Krishna-Gorai/riscv-cache-extension/paper/fig_filter.tex

%% =============================================================================
%%  fig_filter.tex -- the snoop filter's internal mechanism, standalone.
%%
%%  Build:  pdflatex fig_filter.tex   ->  fig_filter.pdf
%%
%%  Drawn in the terminology of the paper's Section V, so that every block and
%%  signal here is defined in the text:
%%    update port from each DCU: "tag + valid update" (the signals that write
%%        its Status-RAM and Tag-RAM), and "fill in flight + address"
%%    the INV REQ selected by the INV REQ arbiter: issued by PE i, address of w
%%        = set index . tag
%%    per (PE, way): Tag-RAM mirror (LUTRAM, read at the set index of w),
%%        valid bit (flip-flop), comparator "stored tag = tag of w", AND with
%%        the valid bit
%%    per PE: OR over the two ways -> "holds the line"; fill comparator ->
%%        "is fetching the line"; OR -> "holds or is fetching"
%%    exclude the requesting PE i -> sharer set S(w);  NOR -> S(w) = empty ->
%%        suppress the broadcast, else broadcast and grant by condition (1)
%%
%%  Routing rule, so that no two lines cross: the "address of w" is one bus
%%  that threads left to right through every block that reads it (Tag-RAM
%%  mirror, valid bit, fill comparator); those blocks take their DCU inputs
%%  from above, the tag comparator hangs below the bus on a tap (junction
%%  dot), and every result flows downwards. Gate inputs are reached by
%%  orthogonal jogs at different heights, the left source always feeding the
%%  left input, so the jogs never cross. Gates are the US shapes rotated so
%%  their inputs face up: after rotate=-90, "input 2" is the LEFT input and
%%  "input 1" the right one (input 4 leftmost on the 4-input NOR).
%%  PE 0 is drawn in full; PE 1-3 are identical and drawn collapsed.
%% =============================================================================
\documentclass[border=3pt]{standalone}
\usepackage{tikz}
\usepackage{times}
\usepackage{amssymb}
\usetikzlibrary{arrows.meta,calc,shapes.gates.logic.US}

\begin{document}
\begin{tikzpicture}[
  x=1mm, y=1mm, font=\scriptsize,
  box/.style  ={draw,rectangle,align=center,inner sep=1.2pt},
  ram/.style  ={box,fill=black!6},
  ff/.style   ={box,fill=black!16},
  op/.style   ={box,fill=white},
  pe/.style   ={box,fill=black!3},
  src/.style  ={box,fill=white},
  new/.style  ={box,fill=black!22,line width=1.1pt},
  g2/.style   ={draw,logic gate inputs=nn,logic gate input sep=5mm,rotate=-90,scale=0.5},
  g4/.style   ={draw,logic gate inputs=nnnn,logic gate input sep=4mm,rotate=-90,scale=0.5},
  ln/.style   ={draw,-{Latex[length=1.4mm]},line width=0.45pt},
  wire/.style ={draw,line width=0.45pt},
  bus/.style  ={draw,line width=1.1pt},
  mir/.style  ={draw,-{Latex[length=1.4mm]},dashed,dash pattern=on 1.6pt off 1.2pt,line width=0.7pt},
  dot/.style  ={circle,fill=black,inner sep=0,minimum size=1.2mm},
  lab/.style  ={font=\tiny,inner sep=0.7pt,fill=white,align=center},
  labr/.style ={font=\tiny,inner sep=0.4pt,rotate=90,anchor=center},
]

% ----------------------------------------------------------- the request
\node[src,minimum width=24mm,minimum height=13mm,anchor=east] (srcb) at (-18, 0)
  {INV REQ selected by\\the INV REQ arbiter:\\[1pt]
   issued by PE $i$,\\address of $w$};
\draw[bus] (-18, 0) -- (2, 0);
\node[lab,anchor=south] at (-8, 0.9) {address of $w$};
\node[lab,anchor=north] at (-8, -0.9) {(set index, tag)};
\draw[ln] (-36, -6.5) -- (-36, -60) -- (30, -60);
\node[lab,anchor=east] at (-36.8, -33) {$i$};

% ----------------------------------------------------------- PE 0 in full
\node[pe,minimum width=68mm,minimum height=7mm,anchor=south west] (dcu0) at (0, 12)
  {\textbf{DCU 0}\\[-1pt] {\tiny update port: its Status-RAM and Tag-RAM write signals; line fill in progress}};

% two ways, centres c = 12 and 38
\foreach \k/\c in {0/12, 1/38} {
  % on the bus: tap for "tag of w", then the Tag-RAM mirror, then the valid bit
  \node[dot] (tp\k) at (\c-10, 0) {};
  \node[ram,minimum width=12mm,minimum height=5mm] (tr\k) at (\c-3, 0)
    {Tag-RAM\\[-1pt]mirror};
  \node[ff,minimum width=6mm,minimum height=5mm] (vb\k) at (\c+7, 0) {valid};
  \draw[bus] (\c-11, 0) -- (\c-9, 0);
  \draw[bus] (\c+3, 0) -- (\c+4, 0);
  \draw[bus] (\c+10, 0) -- (\c+16, 0);
  % update port from DCU 0, straight down into both
  \draw[ln] (\c-3, 12) -- (\c-3, 2.5);
  \draw[ln] (\c+7, 12) -- (\c+7, 2.5);
  \node[labr] at (\c-4.3, 7.2) {tag};
  \node[labr] at (\c+8.3, 7.2) {valid};
  \node[lab] at (\c+2, 4.2) {way \k};
  % comparator below the bus: tag of w from the tap, stored tag from the mirror
  \node[op,minimum width=9mm,minimum height=5mm] (cp\k) at (\c-6.5, -11) {$=$};
  \draw[ln] (tp\k) -- (\c-10, -8.5);
  \draw[ln] (tr\k.south) -- (\c-3, -8.5);
  % AND with the valid bit; left input 2 from the comparator, right input 1
  % from the valid bit, each by its own jog
  \node[and gate US,g2] (an\k) at (\c-2, -22) {};
  \draw[ln] (cp\k.south) |- ($(an\k.input 2)+(0,2)$) -- (an\k.input 2);
  \draw[ln] (vb\k.south) |- ($(an\k.input 1)+(0,4)$) -- (an\k.input 1);
}
\node[lab,anchor=east] at (1.4, -5.2) {tag of $w$};
\node[lab,anchor=west] at (9.6, -5.2) {stored\\[-1pt]tag};
\node[lab,anchor=east] at (7.6, -19.6) {tag match};

% fill comparator, also on the bus, also fed from DCU 0
\node[new,minimum width=14mm,minimum height=7mm] (fc0) at (61, 0)
  {$=$\\[-1pt] {\tiny fill addr., line addr.\ of $w$}};
\draw[mir] (61, 12) -- (61, 3.5);
\node[lab,anchor=east] at (60.2, 7.5) {fill in flight\\[-1pt]+ address};
\draw[bus] (68, 0) -- (73, 0);

% OR over the two ways
\node[or gate US,g2] (orw) at (24, -36) {};
\draw[ln] (an0.output) |- ($(orw.input 2)+(0,2)$) -- (orw.input 2);
\draw[ln] (an1.output) |- ($(orw.input 1)+(0,4)$) -- (orw.input 1);
\node[lab,anchor=west] at (10.8, -28) {way 0 holds};
\node[lab,anchor=west] at (36.8, -28) {way 1 holds};
% OR with the fill term
\node[or gate US,g2] (orf) at (42, -50) {};
\draw[ln] (orw.output) |- ($(orf.input 2)+(0,2)$) -- (orf.input 2);
\draw[ln] (fc0.south) |- ($(orf.input 1)+(0,4)$) -- (orf.input 1);
\node[lab,anchor=west] at (24.8, -42) {PE 0 holds the line};
\node[lab,anchor=west] at (61.8, -25) {PE 0 is fetching the line};
\draw[ln] (orf.output) -- (42, -60);
\node[lab,anchor=west] at (42.8, -56.5) {PE 0 holds or is fetching the line};

% ----------------------------------------------------------- PE 1..3 collapsed
\foreach \j/\x in {1/84, 2/112, 3/140} {
  \node[pe,minimum width=22mm,minimum height=6mm,anchor=south] (dcu\j) at (\x, 12)
    {\textbf{DCU \j}};
  \node[pe,minimum width=22mm,minimum height=22mm] (blk\j) at (\x, -6)
    {\textbf{PE \j}\\[-1pt] same as PE 0:\\[-1pt] Tag-RAM mirror and\\[-1pt]
     valid bit per way,\\[-1pt] comparators, gates};
  \draw[ln]  (\x-4, 12) -- (\x-4, 5);
  \draw[mir] (\x+4, 12) -- (\x+4, 5);
  \draw[ln]  (blk\j.south) -- (\x, -60);
}
\draw[bus] (95, 0) -- (101, 0);
\draw[bus] (123, 0) -- (129, 0);
\node[lab,anchor=east] at (79.4, 8.5) {tag + valid};
\node[lab,anchor=west] at (88.6, 8.5) {fill};

% ----------------------------------------------------------- sharer set
\node[op,minimum width=122mm,minimum height=6mm,anchor=north west] (mask) at (30, -60)
  {exclude the requesting PE $i$ (a DCU is never told about its own write)};
\node[lab,anchor=east] at (29, -64.5) {sharer set $S(w)$,\\[-1pt] one bit per PE};

% NOR over the four bits: S(w) = empty. Input 4 is leftmost; the outer
% sources take the lower jogs so no jog spans a neighbour's vertical.
\node[nor gate US,g4] (nor) at (91, -76) {};
\draw[ln] (42, -66)  |- ($(nor.input 4)+(0,1.5)$) -- (nor.input 4);
\draw[ln] (84, -66)  |- ($(nor.input 3)+(0,4.5)$) -- (nor.input 3);
\draw[ln] (112, -66) |- ($(nor.input 2)+(0,4.5)$) -- (nor.input 2);
\draw[ln] (140, -66) |- ($(nor.input 1)+(0,1.5)$) -- (nor.input 1);

\node[op,minimum width=30mm,minimum height=9mm,anchor=west] (arb) at (138, -86)
  {INV REQ arbiter:\\[-1pt] grant condition (1)};
\draw[ln] (nor.output) |- (138, -86);
\node[lab,anchor=south west] at (93, -85.2) {1: $S(w)=\emptyset$, suppress the broadcast, grant at once};
\node[lab,anchor=north west] at (93, -86.8) {0: broadcast the INV REQ, grant when $\bigwedge_{j \ne i} r_j(t)$};

% ----------------------------------------------------------- legend
\node[ram,minimum width=5mm,minimum height=3mm,inner sep=0,anchor=west] at (-40, -96) {};
\node[font=\tiny,anchor=west] at (-34, -96) {distributed RAM (LUTRAM), read at the set index of $w$};
\node[ff,minimum width=5mm,minimum height=3mm,inner sep=0,anchor=west] at (30, -96) {};
\node[font=\tiny,anchor=west] at (36, -96) {flip-flops};
\node[new,minimum width=5mm,minimum height=3mm,inner sep=0,anchor=west] at (54, -96) {};
\node[font=\tiny,anchor=west] at (60, -96) {imminent residency (Section V-B)};
\draw[bus] (104, -96) -- (110, -96); \node[dot] at (107, -96) {};
\node[font=\tiny,anchor=west] at (112, -96) {bus with tap};
\draw[mir] (130, -96) -- (136, -96);
\node[font=\tiny,anchor=west] at (138, -96) {fill-in-flight signal};

\end{tikzpicture}
\end{document}
