Krishna-Gorai/riscv-cache-extension/paper/fig_exec.pdf

32x32 64x64 128x128
A, B Matrix Size

0

5000

10000

15000

Execution Time (103 Cycles)

Matrix Multiplication

Cores w/o Data Cache
Cores w/ Data Cache
+ Snoop Filter (this work)

32x32 64x64 128x128
Input Matrix Size

0

250

500

750

1000

1250
Execution Time (103 Cycles)

Convolution

256 | 512 | 1024
FFT Input Size per Sample

0

100

200

300

400

500

Execution Time (103 Cycles)

FFT

256 | 512 | 1024
FFT Input Size per Sample

0

100

200

300

400

500

Execution Time (103 Cycles)

FFT, cache-blocked
