Krishna-Gorai/riscv-cache-extension/paper/fig_capacity.pdf

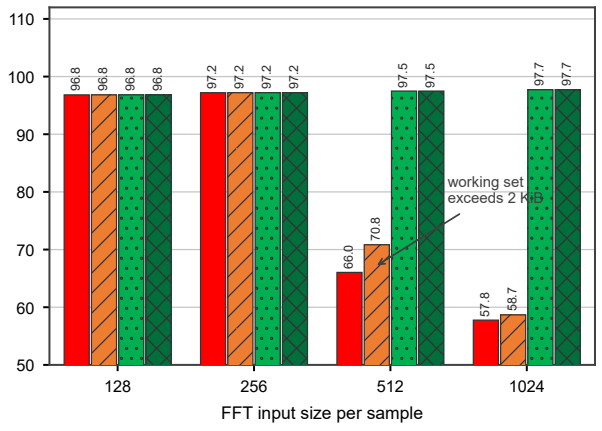
[picture p1: figure]
FFT input size per sample; working set exceeds 2 KiB

128 | 256 | 512 | 1024

### FFT input size per sample

0

100

200

300

400

500

600

## Execution time (103 cycles)

### Execution time

2-way 2 KiB (as stated)
4-way 2 KiB
2-way 8 KiB
2-way 16 KiB

### Read hit rate (%)

### Cache hit rate
