Krishna-Gorai/riscv-cache-extension/paper/date2027.tex

%% =============================================================================
%%  date2027.tex -- An Exact Snoop Filter for Seamless Cache Coherence
%%
%%  Build:  pdflatex date2027.tex   (twice)
%%  Camera ready, with names and the repository URL:
%%          pdflatex "\def\CAMERAREADY{}\input{date2027}"
%%
%%  Defaults to anonymous. DATE's blind-review policy for the research track
%%  must be confirmed before submission -- the repository URL de-anonymises the
%%  work instantly, so it is behind the same toggle as the author block.
%%
%%  Style rule for this file (2026-09-13): written in the register of the
%%  reference paper. Every abbreviation and every symbol is defined at first
%%  use, headings are descriptive, and each result is followed by its reason.
%%  Page budget: DATE allows 6 pages + 1 extra page for references ONLY. The
%%  draft is deliberately over that while the guide's review points are being
%%  worked through (2026-09-18: author said to ignore the limit for now). It
%%  MUST be brought back before submission; check with
%%    pdftotext -f 7 -l 7 date2027.pdf - | head -1     (must be REFERENCES)
%%  The cheapest single cut, measured, is Fig. 4 (memcpy latency): dropping it
%%  alone took the body back inside 6 pages with nothing else touched.
%% =============================================================================
\documentclass[conference]{IEEEtran}
\IEEEoverridecommandlockouts

\usepackage{cite}
\usepackage{amsmath,amssymb}
\usepackage{graphicx}
\usepackage{booktabs}
\usepackage{url}
\usepackage[hidelinks]{hyperref}

\ifdefined\CAMERAREADY \newif\ifanon \anonfalse \else \newif\ifanon \anontrue \fi

\begin{document}

\title{An Exact Snoop Filter for Seamless Cache Coherence in
FPGA-Based Multi-Core RISC-V}

\ifanon
  \author{\IEEEauthorblockN{Anonymous submission}}
\else
  \author{\IEEEauthorblockN{Krishna Gorai}
  \IEEEauthorblockA{Indian Institute of Technology Mandi\\
  Mandi, Himachal Pradesh, India}
  \and
  \IEEEauthorblockN{Bikram Paul}
  \IEEEauthorblockA{Indian Institute of Technology Mandi\\
  Mandi, Himachal Pradesh, India}}
\fi

\maketitle

\begin{abstract}
Private data caches allow the soft cores of an FPGA-based multi-core system to
hide the access latency of a shared memory, but the caches then have to be kept
coherent. A recently proposed cache extension for RISC-V multi-core systems
does this in hardware, with a snooping invalidation bus and without any
modification to the core. In this paper we look at the traffic on that bus.
We reproduce the cache extension at the register-transfer level, instrument
its snoopy bus, and count how many invalidation requests actually invalidate
a cache line in another core. On the benchmark kernels of the original
evaluation the answer is none. The kernels partition their data between the
processing elements, so every written line is private to the core that writes
it, and yet each write is still arbitrated across the whole system and
acknowledged by every other cache. A considerable fraction of each core's
cache busy time is spent waiting for the snoopy bus in this way, and for a
streaming kernel the overhead is larger than the benefit of the cache. We propose a snoop filter that keeps
a copy of the tag and valid bits of every data cache unit inside the snoopy
bus, so that the bus can suppress an invalidation request when no other cache
holds the addressed line or is fetching it. Conventional snoop filters sit at
the receiving cache and work from approximate or coarse-grained sharing
information. Ours is exact and sits at the source, where it becomes part of
the arbitration decision itself, because on this bus the dominant cost of an
unnecessary invalidation is the global serialization it causes and not the
remote tag lookups. A cost model of the bus protocol explains where the
saving comes from. The filter is evaluated in terms of execution time,
coherence correctness and FPGA resource utilization.
\end{abstract}

\begin{IEEEkeywords}
Cache Coherency, Snoop Filter, RISC-V, Multi-Core SoC, FPGA
\end{IEEEkeywords}

% =============================================================================
\section{Introduction}
% =============================================================================

Multi-core systems implemented on FPGAs are increasingly used for embedded and
edge computing, where several soft RISC-V cores share a common memory whose
access latency is high compared to the clock period of the cores. Private data
caches hide this latency. However, as soon as each core caches shared data
the copies have to be kept coherent, and the cost of coherence is charged
against the very performance the caches were added to provide, partly as
hardware for tag and status memories and partly as the time the cores spend
waiting for coherence actions that are serialized across the whole system.

Several hardware and software coherence schemes have been proposed for
scalable architectures~\cite{jetty,cgct,regionscout}, and the RISC-V ecosystem
provides coherent interconnect fabrics for large
systems~\cite{tilelink,openpiton,cifer}. Adopting one of these generally means
integrating with its coherence and interconnect infrastructure, and it may
require changes to the core or to its memory interface. For a designer working
with existing, already verified soft cores, that is the development cost worth
avoiding, and a seamless cache extension avoids it. Kamaleldin \emph{et
al.}~\cite{kamaleldin2024} attach a private, write-through Data Cache Unit
(DCU) to an unmodified RISC-V core through the core's ordinary data port and
keep the DCUs coherent with a snooping invalidation bus, entirely in
hardware.

In this work we reproduce the cache extension of~\cite{kamaleldin2024} at the
register-transfer level in order to find out how much of the coherence traffic
it generates is really necessary. We find that between 6\,\% and 33\,\% of
the time a core spends with an access in its cache goes to waiting for the
snoopy bus, and that over four benchmark kernels the system issues 1{,}048{,}821 invalidation
requests, not one of which invalidates a cache line in another DCU. The
kernels partition their arrays between the Processing Elements (PEs), so
almost every written line is private to one PE, but the bus has no way of
knowing this. We therefore propose an exact snoop filter that answers this
question before the bus arbitrates the request. Our contributions are listed
as follows:

\begin{itemize}
  \item We measure how much of the coherence traffic of the cache extension
        is necessary, and what the rest costs (Section~\ref{sec:measure}).
  \item We propose an exact source-side snoop filter that feeds cache
        residency and fill-in-flight information directly into the
        arbitration of the snoopy bus, so that an unnecessary invalidation
        request is suppressed before it is serialized across the system. A
        cost model of the bus protocol explains where its benefit comes from
        (Section~\ref{sec:filter}).
  \item We evaluate the filter in execution time, coherence correctness and
        FPGA resources, and measure directed invalidation as a possible next
        step (Sections~\ref{sec:eval} and~\ref{sec:rejected}).
\end{itemize}

The rest of the paper is structured as follows.
Section~\ref{sec:related} discusses related work, Section~\ref{sec:design}
describes the cache extension under study, and Section~\ref{sec:measure}
analyzes its coherence traffic. The snoop filter is presented in
Section~\ref{sec:filter} and evaluated in Section~\ref{sec:eval}.
Section~\ref{sec:rejected} reports on directed invalidation, and
Section~\ref{sec:concl} concludes the paper.

% =============================================================================
\section{Related Work}
\label{sec:related}
% =============================================================================

Snoop filtering itself is not new, and we do not claim it as our
contribution. JETTY~\cite{jetty} places a small filter in front of each
receiving cache and uses it to skip the snoops that would miss there anyway,
so that the energy of a tag lookup is not spent on them. Coarse-grain
coherence tracking~\cite{cgct} and RegionScout~\cite{regionscout} work at a
larger granularity: they track the sharing state of regions of hundreds or
thousands of bytes, and a region that is known to be unshared needs no
broadcast at all. All three were designed for SMP servers and large chip
multiprocessors, where the cost of a useless snoop is the energy and the
bandwidth of the remote tag lookups. In that setting an approximate answer is
good enough, because the error can be made one-sided: a filter that claims a
line may be held when it is not merely causes a lookup that would have
happened anyway.

The bus studied here charges for a useless invalidation in a different
currency. Only one invalidation is granted per clock cycle in the whole
system, and the grant is held back until every other cache is ready to accept
it, so the expense is the serialization imposed on every core rather than the
lookups performed by any one of them. Three consequences follow, and together
they are what distinguishes this work; Table~\ref{tab:related} summarizes
them. First, the filter has to sit at the source of the request and take part
in the arbitration decision, since a filter at the receiver cannot prevent a
request from being serialized. Second, it has to be exact rather than
conservative: it decides whether to arbitrate at all, so a false positive is
not a wasted lookup but a lost opportunity, and exactness also lets the same
structure answer \emph{which} caches hold the line, which we use in
Section~\ref{sec:rejected}. Being exact is affordable because the caches of
such a system are small. Third, a source-side filter must know about the line
fills that are in flight, a question that does not arise at the receiving
side, where the cache is aware of its own pending fill; Section~\ref{sec:fill}
shows that ignoring it loses invalidations.

\input{tab_related}

Coherent fabrics for RISC-V such as TileLink~\cite{tilelink},
OpenPiton~\cite{openpiton} and CIFER~\cite{cifer} solve the coherence problem
at a different scale, as complete memory systems. The design studied here is
an extension attached to an unmodified core through its existing memory port,
and that is what confines its coherence traffic to a single shared bus.

% =============================================================================
\section{The Cache Extension Under Study}
\label{sec:design}
% =============================================================================

\begin{figure*}[t]
\centering

\caption{Overview of the multi-core RISC-V architecture with the cache
extension of~\cite{kamaleldin2024} and the snoop filter added by this work
(shaded, with its mirror update port per DCU dashed). Every PE is wired as
PE~0; the signal names are those of Section~\ref{sec:design}.}
\label{fig:arch}
\end{figure*}

We describe the cache extension of~\cite{kamaleldin2024} as far as is needed
to follow the measurements, keeping to the terminology of the original paper.

\subsection{Multi-core RISC-V Architecture}

The target system, shown in Fig.~\ref{fig:arch}, consists of a scalable number
of RISC-V Processing Elements (PEs). Each PE hosts an in-order RV32 core, a
private Data Cache Unit (DCU), a scratchpad Instruction Tightly Coupled Memory
(ITCM), and an Instruction-Bridge and a Data-Bridge that connect the core to the
local memories and to a shared AXI4 crossbar, behind which sit a shared
instruction memory, used as boot memory, and a coherent shared data memory. A
single snoopy bus is connected to the DCU of every PE and manages the
invalidation of cache lines between the private DCUs.

\subsection{Data Cache Unit}

The DCU is a two-way set-associative, write-through, no-allocate data cache
with a Least Recently Used (LRU) replacement policy. Every write is forwarded
to the shared data memory, and a write that misses does not install a line.
Requests are processed in two sequential pipeline stages. The first stage
accepts a request either from the local core, which can be a read request
(READ REQ) or a write request (WRITE REQ), or from the snoopy bus, which can
only be an invalidation request (INV REQ). For a core request it reads the
valid bit from the Status-RAM and the tag from the Tag-RAM, and at the same
time forwards the request to the snoopy bus, a WRITE REQ as an INV REQ. In
the second stage the Hit Check Logic (HCL) decides between hit and miss and
the Cache Control Logic (CCL) acts on the request: a READ REQ that misses
issues a memory read request (MEM READ REQ) and fills the LRU way of the set
with the returned line, a WRITE REQ becomes a memory write request
(MEM WRITE REQ), and an INV REQ clears the valid bit of the addressed line if
it is resident. An INV REQ has priority over the local core; a core request
that occupies the first stage when one arrives is moved into a holding
register and presented again afterwards. A Stall Control Logic (SCL) stalls
the first stage until the bus grants its forwarded request, and the second
stage until the response (MEM RESP) of a MEM READ REQ or the grant of a
MEM WRITE REQ arrives, that is, for the access latency of the shared data
memory.

\subsection{Snoopy Bus}

The unit of coherence is the cache line, the same 16 bytes the DCU allocates
and refills. An INV REQ carries a line address, the receiving DCU compares it
against its tags at line granularity, and the screening described below works
at the same granularity, so two PEs writing different words of one line are
treated as sharing it.

The snoopy bus consists of two Round Robin (RR) arbiters, an Invalidation Table
and a Link Register. The first arbiter, which we call the INV REQ arbiter
from here on, arbitrates the INV REQs of all PEs and grants at most one per
clock cycle. When an INV REQ is granted, its address is broadcast to the DCUs
of all other PEs, which clear the addressed line if they hold it. The grant is
withheld until every other DCU is able to accept the broadcast, so that no
invalidation can be lost. This last rule is the one the rest of the paper
turns on. It couples the DCUs to each other: what a write costs is decided by
what every other DCU happens to be doing at that moment, and not by what any
cache actually holds, so the protocol charges the same price for a write that
nobody else cares about as for one that everybody has to hear. The second arbiter handles the atomic Load-Reserved
(LR) and Store-Conditional (SC) requests together with the Link Register. The
bus also guarantees a Multiple-Readers-Single-Writer (MRSW) invariant: plain
READ REQs are not arbitrated, but while a core has an INV REQ pending for a
line, recorded in the Invalidation Table, a READ REQ of another core to that
line is withheld until the INV REQ is granted.

\subsection{Reproduction and Experimental Setup}

We implemented this architecture in SystemVerilog in the configuration given
in the original paper: four PEs, each with an unmodified CV32E40P core and a
private 2\,KiB two-way DCU with 16-byte lines and 64 sets, a 256\,KiB shared
data memory and a 32\,KiB shared instruction memory behind an AXI4 crossbar.
A non-coherent version, in which each core accesses the shared data memory
directly through its Data-Bridge and has no DCU, is built from the same
sources by changing one parameter; it serves as the baseline for all
comparisons. The shared memories are modelled with a configurable access
latency, which we call the memory latency from here on. It is the number of
clock cycles between the acceptance of a MEM READ REQ and the first data beat
of its MEM RESP. We use three synthetic settings of it. Two cycles corresponds to the
on-chip block RAM (BRAM) of the original design, while eight and twenty cycles
are higher-latency configurations representative of off-chip access classes;
we did not implement an off-chip memory controller, and these figures are not
a model of one.

Execution time is read from the cycle counter of the cores as the number of
clock cycles until the slowest PE has finished. The benchmark kernels are the
memory copy, matrix multiplication, 2-D convolution and Fast Fourier
Transform (FFT) kernels of the original evaluation, which we refer to as
memcpy, matmul, conv2d and FFT. Each of them partitions its data between the
four PEs, and every run is checked against a golden result. In addition, each
DCU carries hardware counters for the cycles in which it holds a core request
(busy cycles), the cycles its first stage waits for a grant of the snoopy bus
(snoop-stall cycles), the INV REQs it receives, and those among them that
find a valid matching line to clear.

% =============================================================================
\section{Analysis of the Coherence Traffic}
\label{sec:measure}
% =============================================================================

\subsection{Time Spent Waiting for the Snoopy Bus}

We express the snoop-stall cycles of a DCU as a fraction of its busy cycles,
that is, of the time the core spends with an access in its cache. We call this
its cache busy time; it is not the total execution time, which also covers
everything the core does without touching the cache. At a memory latency of
two cycles the share is 14.3\,\% on memcpy,
15.8\,\% on matmul, 6.5\,\% on conv2d and 5.8\,\% on FFT. At a memory latency
of twenty it rises to 33.0\,\%, 32.9\,\%, 19.0\,\% and 12.2\,\%,
respectively. The share grows with the memory latency because each grant is
held for longer, as will be shown in Section~\ref{sec:model}. One might
suspect the READ REQs that the Invalidation Table withholds under the MRSW
invariant. We counted them, and across all four kernels not a single
READ REQ is withheld. For these workloads the measured waiting is therefore
attributable to the INV REQs.

\subsection{None of the Invalidation Requests Are Necessary}

We therefore let each DCU count the INV REQs it receives and how many of them
find a valid matching line to clear. We call an INV REQ useful if at least
one other DCU clears a line because of it. The system issues 823{,}338
INV REQ broadcasts on matmul, 139{,}182 on conv2d, 61{,}683 on FFT and
24{,}618 on memcpy, more than a million in total, and on all four kernels the
number of useful ones is zero. To make sure the counter itself works, we ran
it on our coherence testbench of Section~\ref{sec:eval}, which shares data on
purpose; there it reports 345 useful INV REQs out of 921.

The zeros are thus a property of the kernels as much as of the design, and we
want to be plain about it. These four kernels are data-parallel and partition
their arrays between the PEs, so practically every written line belongs to one
PE only, and a reader is entitled to ask whether the result survives once the
data really is shared. It does, and for a reason that the zeros make easy to
miss: what the filter removes is not sharing but the announcement of writes to
caches that do not hold the line, and a workload can share a great deal and
still make almost all of those announcements pointless. We therefore added a
fifth kernel in which the PEs exchange data every step, and report it
separately in Section~\ref{sec:shared}. It is also the kernel we use in
Section~\ref{sec:rejected} to measure directed invalidation.

% =============================================================================
\section{Proposed Snoop Filter}
\label{sec:filter}
% =============================================================================

\subsection{Structure}

Before it grants an INV REQ, the bus needs to know whether there is any other
DCU that has to receive it. The proposed snoop filter answers this with a
mirror of the tag and valid bits of all DCUs, kept inside the snoopy bus. Only
two events change the state of a DCU: a line fill, which writes a tag into a
way and sets its valid bit, and an invalidation, which clears a valid bit.
Each DCU exports these two events on a small update port driven by the same
signals that write its own Status-RAM and Tag-RAM, which keeps the mirror
synchronized with the cache state. Section~\ref{sec:sva} checks that
synchronization as an assertion rather than leaving it as a claim. For the
INV REQ selected by the arbiter, the
set index of its address reads one entry from every array, the stored tag is
compared with the tag of the address and the result is ANDed with the valid
bit; the two ways of each DCU are ORed, and the requesting PE is excluded.
This path is shown in Fig.~\ref{fig:filter}. A hashed structure such as a
Bloom filter would be smaller, but it can only over-approximate the set of
resident lines, and removing an entry from one needs exactly the information
the mirror already holds.

\begin{figure}[t]
\centering

\caption{Decision path of the snoop filter for the INV REQ selected by the
arbiter, issued by PE $i$ with address of $w$. The address bus reads every
Tag-RAM mirror and valid bit at its set index. PE~1--3 are identical to PE~0.
The fill comparator is shaded; it is the term of Section~\ref{sec:fill}.}
\label{fig:filter}
\end{figure}

\subsection{Cache Lines in Flight}
\label{sec:fill}

A mirror of the tag arrays answers the question \emph{does another cache hold
this line?} The question the bus actually has to ask is \emph{does another
cache hold this line, or is it about to hold it because it is fetching it?}
The difference between the two is small enough to overlook and large enough to
break coherence. Consider a DCU that has issued a
MEM READ REQ for a missing line and is waiting for the MEM RESP. It holds
nothing for that line yet, so the line does not appear in the mirror, and yet
this DCU is precisely the one that must receive an INV REQ for it, because
receiving it during this interval is what cancels the fill. Suppress the
broadcast and the DCU installs a line that has already been invalidated. What
the bus needs is therefore residency \emph{or imminent residency}. Each DCU exports, in addition to its
mirror updates, a signal indicating that a line fill is in progress together
with its address, and the filter answers over the union of the mirror and
these fill-in-flight signals. The fill signal stays asserted from the cycle
the MEM READ REQ is issued until the cycle the line is written into the cache,
which is also the cycle in which the mirror learns the new tag, so the line is
covered at every moment by one of the two. This is not just a precaution. Over
ten randomized interleavings of our coherence testbench, 20 out of 2{,}241
granted INV REQs addressed a line that no other DCU held but one DCU was
fetching, and a mirror of resident lines alone would have suppressed each of
them wrongly.

\subsection{Correctness of Suppression}

When the filter reports that no other DCU holds the addressed line or is
fetching it, a broadcast of the INV REQ could not clear a line anywhere, so
leaving it out cannot be observed. Everything
else in the bus stays as it was: INV REQs that are needed are still
arbitrated, broadcast and acknowledged as before, and the Invalidation Table
still withholds READ REQs according to the MRSW invariant.

\subsection{Checking the Properties}
\label{sec:sva}

The argument above rests on two claims: that the mirror agrees with the caches,
and that a suppressed invalidation was one that no other DCU needed. A counter
that fires 20 times in 2{,}241 grants shows that a case was reached; it says
nothing about the cycles in which it was not. We therefore state both claims as
properties and check them, by proof where that is possible and by assertion in
simulation otherwise.

\subsubsection{Proof}
The filter's own obligation is that it must never report that nobody holds a
line when somebody does. That direction is the one that matters: a false
negative makes the bus suppress an invalidation that was needed, whereas a
false positive costs only a broadcast, which is what the unfiltered design
sends on every write in any case. We prove it against a reference model of a
single cache entry, with the entry -- which core, which set, which way -- left
free for the solver to pick, so that a proof covers every entry of every cache
rather than one chosen by hand. Nothing constrains the update port, so the
proof holds for every sequence of fills and invalidations the caches could
produce, not only those a testbench happens to generate. Property-directed
reachability discharges it in 331\,s with Yosys and ABC, unbounded, for four
cores, two ways, 32 sets and 26-bit addresses. To confirm the property is not
vacuous, we reran the same proof against a filter modified to ignore its
second way, and it fails in six seconds with a counterexample three cycles
long.

\subsubsection{Assertions in simulation}
The other two claims involve the DCUs and the bus, which are far larger, so we
check them in simulation rather than proving them. They are stated against the
DCUs' own Status-RAM, Tag-RAM and fill state, never against the filter's
outputs, which would be circular:
\begin{itemize}
  \item[P1] every entry of the mirror equals the corresponding entry of that
        DCU's arrays, in the valid bit and, where valid, in the tag;
  \item[P2] when the bus grants an INV REQ without broadcasting it, no other
        DCU holds the addressed line;
  \item[P3] the same, for a DCU that holds nothing yet but is fetching it.
\end{itemize}
P1 is the meaning of the word exact, and P3 is the property a mirror of
committed tags alone violates. Over ten randomized interleavings the
properties held in every cycle: 81{,}734 cycles in total, 923 suppressions
checked against the real cache state, and 78{,}336 mirror entries compared,
each entry of the mirror being visited 153 times.

\subsection{Cost Model}
\label{sec:model}

In this section we work out from the bus protocol what suppressing a
broadcast is worth, and then check the result against the measurements. Let
$P$ be the number of PEs, indexed by $i$ and $j$. For a WRITE REQ $w$ issued
by PE $i$, let $a(w)$ be the clock cycle in which $w$ enters the first stage
of its DCU and $g(w)$ the cycle in which the corresponding INV REQ is granted.
Let $\mathrm{arb}(t)$ be the PE selected by the INV REQ arbiter in cycle $t$,
and let $r_j(t) = 1$ if the DCU of PE $j$ can accept an INV REQ in cycle $t$.
The sharer set $S(w)$ is the set of PEs other than $i$ whose DCU holds or is
fetching the line addressed by $w$. The original protocol grants an INV REQ
in the first cycle in which the arbiter selects it \emph{and} every other DCU
is ready to accept it:
\begin{equation}
g(w) = \min\Big\{t \ge a(w) : \mathrm{arb}(t) = i \;\wedge\; \textstyle\bigwedge_{j \ne i} r_j(t)\Big\}.
\label{eq:grant}
\end{equation}
A DCU is ready only while its first stage does not already hold an INV REQ,
and an INV REQ leaves that stage only when the second one is free, which it is
not for the full memory latency of any MEM READ REQ or MEM WRITE REQ in
progress. On grant, an INV REQ is inserted into the first stage of each of the
other $P{-}1$ DCUs, where it takes priority over the local core, so each of
those pipelines loses a cycle if it had a core request to process. The cost of
$w$ to the whole system is therefore
\begin{equation}
C(w) = \big(g(w) - a(w)\big) + \sum_{j \ne i} \rho_j\big(g(w)\big),
\label{eq:cost}
\end{equation}
where $\rho_j(t) \in \{0, 1\}$ is one if the DCU of PE $j$ had a core request
to delay in cycle $t$. The
conjunction in (\ref{eq:grant}) ties the pipelines of all PEs together: a
WRITE REQ on PE $i$ has to wait until a MEM READ REQ on PE $j$ has completed,
whether or not the two PEs share any data at all. This is the reason why the
snoop-stall share of Section~\ref{sec:measure} grows with the memory latency.
And neither term of (\ref{eq:cost}) depends on which lines the caches hold.

With the filter, the cost does depend on the cache state. When $S(w)$ is read
from the mirror, the grant condition becomes $\mathrm{arb}(t) = i \wedge
\big(S(w) = \emptyset \vee \bigwedge\nolimits_{j \ne i} r_j(t)\big)$, and
INV REQs are inserted into the other DCUs only when $S(w) \ne \emptyset$. For
a WRITE REQ with an empty sharer set, both terms of (\ref{eq:cost}) vanish
and only the arbitration wait is left, which is non-zero only when two PEs
present a WRITE REQ in the same cycle. If every WRITE REQ of a kernel has an
empty sharer set, which is what Section~\ref{sec:measure} found for all four
kernels, the saving over the whole kernel is the entire coherence overhead
less the arbitration collisions. That is the same saving an oracle would
obtain by suppressing every broadcast.

Both terms of (\ref{eq:cost}) can be observed, so the model can be checked
rather than fitted. The snoop-stall cycles removed by the filter are the first
term and give a lower bound on the saving; the same plus one cycle per
broadcast received gives an upper bound. Per DCU, at a memory latency of two,
the measured saving falls inside this bracket on every kernel: matmul
$120{,}539 \le 243{,}100 \le 326{,}373$ cycles, conv2d $5{,}185 \le 13{,}795
\le 39{,}980$, FFT $892 \le 4{,}865 \le 16{,}312$, memcpy $1{,}792 \le 2{,}302
\le 7{,}946$.

In hardware, the mirror is one memory array per (PE, way) pair, addressed by
the set index. The tags are kept outside any reset, because a tag is only
compared when its valid bit is set, and this lets them map to distributed RAM
(LUTRAM); the valid bits are kept in flip-flops, where they can be reset and
read for all arrays at once. Our first implementation held both under an
asynchronous reset, and Vivado mapped it entirely to flip-flops: 11{,}776 of
them and 3{,}202 LUTs, against 512 and 408 here.

% =============================================================================
\section{Evaluation and Performance Analysis}
\label{sec:eval}
% =============================================================================

\subsection{Execution Time}

\begin{figure*}[t]
\centering

\caption{Execution time of the benchmark kernels over the non-coherent
system, the coherent system with the cache extension, and the coherent system
with the proposed snoop filter. The fourth panel is the FFT with its stages
reordered so that its working set fits into the cache.}
\label{fig:exec}
\end{figure*}

\input{tab_exec}

Fig.~\ref{fig:exec} shows the execution time of the matmul, conv2d and FFT
kernels for the problem sizes used in the original evaluation, and
Table~\ref{tab:exec} lists the cycle counts behind it. For matmul and conv2d
the cache extension reduces the execution time by roughly 40\,\% at every
problem size, as in the original evaluation. The reduction does not
fall off with the problem size because what has to stay resident is not the
whole data set but only the reuse footprint of the kernel, the bytes a core comes
back to before moving on. For matmul this is one row of the
second matrix, $4N$ bytes for an $N \times N$ matrix of 32-bit words; for
conv2d it is the three-row sliding window of the input, $12N$ bytes. At the
largest problem size these come to 512\,B and 1536\,B, and both fit into the
2\,KiB DCU.

For FFT this no longer holds. The original evaluation reports a uniform
reduction of about 23\,\%. We match it at $N{=}256$ points, but the reduction
disappears at $N{=}512$ and becomes negative at $N{=}1024$, where the cache
makes the kernel slower than having no cache. The reuse footprint explains
this too. The FFT touches all $N$ complex points in every stage, $8N$
bytes in total, which is 2\,KiB at $N{=}256$ and 8\,KiB at $N{=}1024$. At
$N{=}512$, doubling the associativity at 2\,KiB recovers only 3.8\,\% of the
execution time, whereas quadrupling the capacity recovers 24.5\,\%, so the
cause is capacity. With an 8\,KiB DCU, FFT reproduces the original result at
every size (24.8, 24.8 and 24.5\,\%). With the 2\,KiB stated in the original
text it does not, so the reported result implies either a larger cache or a
smaller working set than described.

The collapse comes from the order in which the kernel accesses its data, and
the fourth panel of Fig.~\ref{fig:exec} shows that it can be removed in
software. A radix-2 butterfly in stage $s$ pairs elements $2^s$ positions
apart; once $2^s$ is a multiple of a block size $B$, the remaining stages fall
apart into $B$ independent transforms over strided columns. Running the early
stages block by block and the late ones column by column keeps the working set
inside the DCU, and every butterfly still sees the same operands, so the
output is bit-identical. At $N{=}1024$ the reduction improves from
$-4.3\,\%$ to $+10.4\,\%$, and to $18.2\,\%$ with the filter; at $N{=}256$ the
extra loop structure costs about 6\,\%. The filter removes coherence traffic,
not cache misses, so its contribution stays at seven to eight percentage
points in both FFT panels.

Compared with the coherent system without the filter, the filter improves the
execution time by $1.222\times$ on matmul, $1.123\times$ on memcpy,
$1.089\times$ on conv2d and $1.061\times$ on FFT, a geometric mean of
$1.122\times$. We also compare against an oracle, that is, a bus that
suppresses every INV REQ broadcast unconditionally. Simulating such a bus is
only sound because none of the broadcasts are needed on these kernels. The
filter reaches the oracle on every kernel, cycle for cycle, as the cost model
of Section~\ref{sec:model} predicts. The snoop-stall counter confirms the
mechanism. On conv2d it falls from 20{,}848 cycles to 109, and on memcpy from
7{,}168 to 1. On FFT it falls only from 6{,}521 to 2{,}955, because the LR and
SC requests used for synchronization still have to pass through the arbiters.

\subsection{Memory Copy Latency}

\begin{figure*}[t]
\centering

\caption{Memory copy latency for several data transfer sizes at memory
latencies of two, eight and twenty cycles. At two the cache extension is
slower than the non-coherent system at every size; the ${\approx}50\,\%$
reduction of the original evaluation appears between eight and twenty.}
\label{fig:memcpy}
\end{figure*}

The memcpy kernel gave the most unexpected result. At a memory latency of
two cycles the coherent system with the cache extension is actually
\emph{slower} than the non-coherent system without any cache, at $0.975\times$
the speed of the baseline; with the filter it is $1.095\times$ faster. The
slowdown is the cost of announcing private writes, and Fig.~\ref{fig:memcpy}
shows that it holds at every transfer size: from 4 to 32\,KiB the cache
extension is 2.5\,\% to 7.6\,\% slower than the baseline, and the filter turns
that into a gain of 8.2\,\% to 9.0\,\%. Raising the memory
latency brings back the result of the original evaluation, with a latency
reduction of 34\,\% at a memory latency of eight and 56\,\% at twenty,
against the roughly 50\,\% reported there. A streaming kernel reuses no data,
so when there is little memory latency to hide, only the coherence overhead
is left.

\subsection{A Workload That Does Share Data}
\label{sec:shared}

\input{tab_stencil}

The four kernels above never make the filter let a broadcast through, so on
their own they cannot answer what happens when the data is genuinely shared.
For that we use a fifth kernel, a five-point Jacobi stencil on a
$32\times32$ grid over eight time steps. Each PE owns a band of rows and
exchanges its two boundary rows with its neighbours at every step, so the
sharing is real, it is periodic, and the sharer set of a boundary write is
exactly one of the other three PEs.

Table~\ref{tab:stencil} gives the result. The unfiltered system delivers
27{,}690 invalidations over the run, of which 168 are useful: sharing this
regular still leaves 99.4\,\% of the announcements pointless, which is the
point the four private-data kernels state in their extreme form. The filter
delivers 504 of them and keeps all 168 useful ones, a 55-fold reduction in
traffic, and it is worth $1.015\times$ at a memory latency of two,
$1.049\times$ at eight and $1.113\times$ at twenty. The gain is smaller than
on the private-data kernels, as the cost model requires: writes to a boundary
row have a non-empty sharer set, so both terms of (\ref{eq:cost}) survive for
them and only the interior of each band is suppressed. What the stencil shows
is that the benefit degrades gracefully with the amount of real sharing
rather than disappearing at the first shared line.

\subsection{Coherence Verification}

The four data-parallel kernels never make the filter let a broadcast through,
so on their own they cannot show that it is safe. Our coherence
testbench does. It runs a producer/consumer exchange and a randomized
four-core stress test over a small shared window, so that half of its
INV REQs are useful, and with the filter it passes 3{,}112 checks.
Among them is a version-monotonicity check: a core that has observed version
$k$ of a location must never afterwards observe an older version, which is
the symptom of a lost invalidation. The filter suppressed 282 of 921
broadcasts and delivered every one that was needed.

\subsection{Resource Utilization and Timing}

\input{tab_hier}

Table~\ref{tab:fpga} gives the post-place-and-route resource utilization with
the filter, obtained with Vivado 2025.1 for an AMD/Xilinx Zynq UltraScale+
XCZU7EV at 60\,MHz, which is the clock frequency of the original design. The
filter costs 1{,}064 look-up tables (LUTs) and 516 flip-flops on top of the
coherent system without it, under 4\,\% of that system, and no BRAM or DSP
blocks. Both systems meet all timing constraints, at $+1.199$\,ns of worst
negative slack with the filter and $+1.265$\,ns without, so the filter costs
66\,ps on a 16.667\,ns clock period. Both numbers come from the same Vivado
session, because separate runs of this design vary by up to 1.7\,ns in slack.
At 75\,MHz an earlier pair of builds had only the unfiltered system meeting
timing, on a path that is 86\,\% routing delay, so we evaluate at 60\,MHz.

% =============================================================================
\section{Directed Invalidation}
\label{sec:rejected}
% =============================================================================

Since the mirror knows not only \emph{whether} another DCU holds the line but
also \emph{which} ones do, the bus could deliver the INV REQ only to the
members of $S(w)$ and wait only for those. Only an exact filter may do this:
under multicast a missing sharer bit drops an invalidation that was needed,
whereas under suppression it would only have cost a redundant broadcast.

We measured it on the stencil kernel of Section~\ref{sec:shared}, whose
sharer sets make it the best case for steering. The mechanism does what it
was built to do: it delivers 168 invalidations, every one of them useful,
against the filter's 504, and it reduces the residual snoop stall by up to a
factor of eleven. The execution time improves by 0.1\,\% to 0.3\,\%. The
reason is visible in (\ref{eq:cost}): once suppression has removed every
WRITE REQ with an empty sharer set, what is left belongs to writes that some
other DCU genuinely has to be told about, and for those the writer has to
wait whether the broadcast is steered or not. Removing all of the filtered
design's remaining snoop stall would be worth at most 3.4\,\% at a memory
latency of twenty, and directed invalidation collects a small fraction of
that. We report it because the question "why not just multicast?" is the
obvious one to ask of an exact filter, and the answer turns out to be that
exactness is worth having for suppression, not for steering.

% =============================================================================
\section{Conclusion}
\label{sec:concl}
% =============================================================================

On the benchmark kernels of its own evaluation, the seamless cache extension
we reproduced spends 6\,\% to 33\,\% of each core's cache busy time on
invalidation requests that invalidate nothing. An exact mirror of the tag and
valid bits of all DCUs, covering the lines being fetched as well, lets the bus
suppress this traffic for 1{,}064 LUTs and is worth $1.122\times$.

\ifanon
\else
The design, the measurements and the scripts that regenerate every table are
available at \url{https://github.com/Krishna-Gorai/riscv-cache-extension}.
\fi

%% DATE allows "one extra page ... only for bibliographic references". The
%% body must end by page 6; page 7 is references only.
\newpage
\begin{thebibliography}{1}
\bibitem{kamaleldin2024}
A.~Kamaleldin, M.~Nickel, S.~Wu and D.~G\"ohringer,
``Seamless Cache Extension for FPGA-based Multi-Core RISC-V SoC,''
in \emph{Proc. IEEE 37th Int. System-on-Chip Conf. (SOCC)}, 2024.

\bibitem{jetty}
A.~Moshovos, G.~Memik, B.~Falsafi and A.~Choudhary,
``JETTY: Filtering Snoops for Reduced Energy Consumption in SMP Servers,''
in \emph{Proc. 7th Int. Symp. High-Performance Computer Architecture (HPCA)},
2001.

\bibitem{cgct}
J.~F.~Cantin, M.~H.~Lipasti and J.~E.~Smith,
``Improving Multiprocessor Performance with Coarse-Grain Coherence Tracking,''
in \emph{Proc. 32nd Int. Symp. Computer Architecture (ISCA)}, 2005, pp.
246--257.

\bibitem{regionscout}
A.~Moshovos,
``RegionScout: Exploiting Coarse Grain Sharing in Snoop-Based Coherence,''
in \emph{Proc. 32nd Int. Symp. Computer Architecture (ISCA)}, 2005, pp.
234--245.

\bibitem{tilelink}
W.~Terpstra,
``TileLink: A Free and Open-Source, High-Performance Scalable Cache-Coherent
Fabric Designed for RISC-V,'' in \emph{RISC-V Workshop}, 2017.

\bibitem{openpiton}
J.~Balkind \emph{et al.},
``OpenPiton+Ariane: The First Open-Source, SMP Linux-booting RISC-V System
Scaling from One to Many Cores,'' in \emph{Workshop on Computer Architecture
Research with RISC-V (CARRV)}, 2019.

\bibitem{cifer}
A.~Li \emph{et al.},
``CIFER: A Cache-Coherent 12nm 16mm$^2$ SoC with Four 64-Bit RISC-V Application
Cores, 18 32-Bit RISC-V Compute Cores, and a 1541 LUT6/mm$^2$ Synthesizable
eFPGA,'' in \emph{IEEE Int. Solid-State Circuits Conf. (ISSCC)}, 2023.
\end{thebibliography}

\end{document}
