Krishna-Gorai/riscv-cache-extension/paper/tab_hier.tex

%% Per-module resource breakdown. Generated from
%%   python scripts/table1.py filtered
%% and transcribed here; regenerate that if the build changes.
%%
%% Single column, in the shape of the original's Table I: the module tree down
%% the left, then LUTs, FFs, BRAMs, DSPs, and Available / Utilisation rows
%% under the rule. The instance count is folded into the name and the LUTRAM
%% column is gone -- the one number from it that matters, the filter's 208
%% LUTRAM out of 408, is stated in the text where it is argued.
%%
%% Re-measured 2026-09-08 against the RTL that covers fills in flight, both
%% variants in one batch. No total row inside the tree on purpose: Vivado's
%% figure for the SoC is not the sum of the rows above it -- a LUT shared across
%% a hierarchy boundary counts against both children but once against the
%% parent -- so a total under the column would read as an arithmetic error. The
%% tool's own figures sit below the rule instead, where they are plainly a
%% separate statement.
\begin{table}[t]
\caption{Post-place-and-route resource utilization of the coherent multi-core
system with the proposed snoop filter, AMD/Xilinx XCZU7EV at 60\,MHz.}
\label{tab:fpga}
\centering
\scriptsize
\setlength{\tabcolsep}{3.5pt}
\begin{tabular}{@{}lrrrr@{}}
\toprule
Module & LUTs & FFs & BRAMs & DSPs \\
\midrule
\textbf{Processing element} ($\times$4)      & 17{,}833 & 9{,}948 & 32 & 20 \\
\quad RISC-V core, CV32E40P                  & 16{,}929 & 8{,}404 &  0 & 20 \\
\quad ITCM + Instr.-Bridge                   &      252 &      36 & 32 &  0 \\
\quad Data-Bridge                            &      319 &      32 &  0 &  0 \\
\quad AXI4 masters ($\times$3 per PE)        &      333 & 1{,}476 &  0 &  0 \\
\textbf{Cache extension}                     & \textbf{6{,}540} & \textbf{4{,}628} & 20 & 0 \\
\quad Data Cache Unit ($\times$4)            & 5{,}816 & 3{,}998 & 20 &  0 \\
\quad Snoopy bus                             &      728 &     630 &  0 &  0 \\
\quad\quad \textbf{snoop filter (this work)} & \textbf{408} & \textbf{512} & 0 & 0 \\
\textbf{AXI4 crossbar}                       & 2{,}125 &     279 &  0 &  0 \\
\textbf{Shared data memory}, 256\,KiB        &      724 &     150 & 64 &  0 \\
\textbf{Shared instr.\ memory}, 32\,KiB      &      506 &      86 &  8 &  0 \\
\midrule
Whole device, as reported by the tool        & 27{,}845 & 15{,}670 & 124 & 20 \\
Available                                    & 230{,}400 & 460{,}800 & 312 & 1{,}728 \\
Utilisation (\%)                             &    12.09 &     3.40 & 39.74 & 1.16 \\
\bottomrule
\end{tabular}
\end{table}
