Krishna-Gorai/riscv-cache-extension/paper/fig_memcpy.pdf

4 KiB | 8 KiB | 16 KiB | 32 KiB
Data Transfer Size

0

10

20

30

40

Latency (10

3 Cycles)

MemLat 2 (on-chip BRAM)

4-Cores w/o Data Cache
4-Cores w/ Data Cache + Snoop Filter (this work)
4 KiB | 8 KiB | 16 KiB | 32 KiB
Data Transfer Size

0

20

40

60

80

Latency (10

3 Cycles)

MemLat 8

4 KiB | 8 KiB | 16 KiB | 32 KiB
Data Transfer Size

0

50

100

150

Latency (10

3 Cycles)

MemLat 20 (off-chip class)
