Krishna-Gorai/riscv-cache-extension/paper/fig_filter.pdf

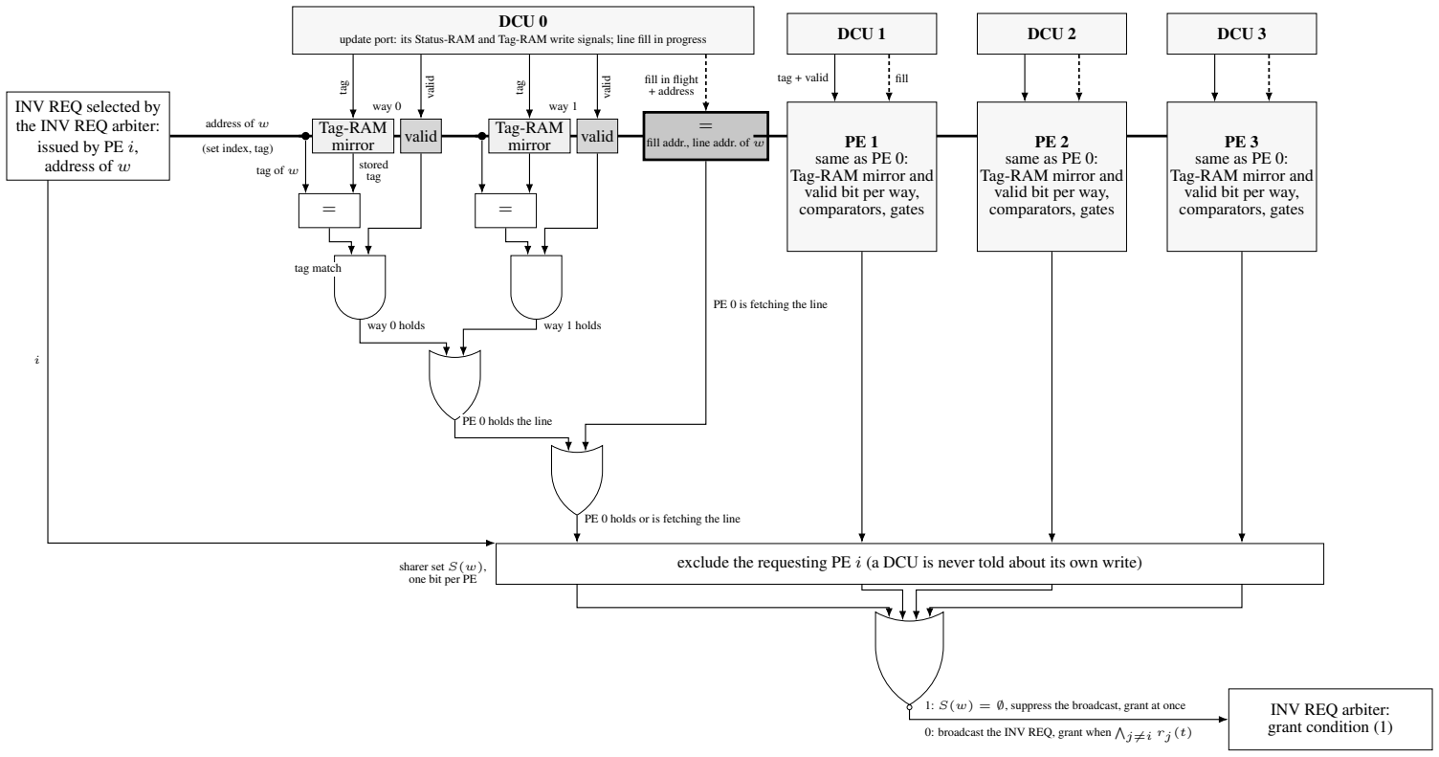
[picture p2: figure]
INV REQ selected by the INV REQ arbiter: issued by PE i, address of w; address of w; (set index, tag); DCU 0; Tag-RAM; mirror; valid tag; valid; way 0; way 1; tag of w; stored; tag; tag match; fill addr., line addr. of w; fill in flight + address; way 0 holds; way 1 holds; PE 0 holds the line; PE 0 is fetching the line; PE 0 holds or is fetching the line; DCU 1; PE 1 same as PE 0: Tag-RAM mirror and valid bit per way, comparators, gates; DCU 2; PE 2 same as PE 0: Tag-RAM mirror and valid bit per way, comparators, gates; DCU 3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

update port: its Status-RAM and Tag-RAM write signals; line fill in progress

exclude the requesting PE i (a DCU is never told about its own write) sharer set S(w),

1: S(w) = ∅, suppress the broadcast, grant at once

distributed RAM (LUTRAM), read at the set index of w | flip-flops | imminent residency (Section V-B) | bus with tap | fill-in-flight signal
