Krishna-Gorai/riscv-cache-extension/paper/fig_exec_repro.pdf

32x32 | 64x64 | 128x128
| A, B Matrix Size

0

2500

5000

7500

10000

12500

15000
Execution Time (103 Cycles)

Matrix Multiplication

Cores w/o Data Cache
Cores w/ Data Cache
32x32 | 64x64 | 128x128
| Input Matrix Size

0

200

400

600

800

1000

1200
Execution Time (103 Cycles)

Convolution

256 | 512 | 1024
FFT Input Size per Sample

0

100

200

300

400

500

Execution Time (103 Cycles)

FFT
