Krishna-Gorai/riscv-cache-extension/paper/fig_stall.pdf

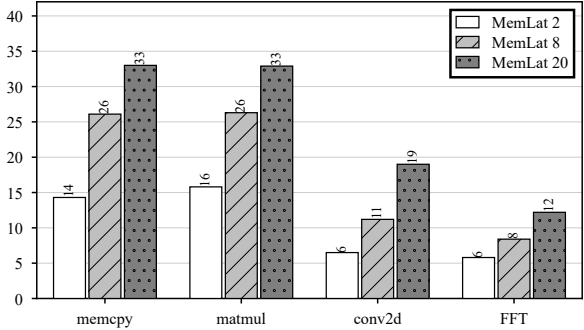
[picture p6: figure]
memcpy; matmul; conv2d; FFT; MemLat 2 MemLat 8 MemLat 20

Time on the coherence bus (\%)
