Krishna-Gorai/riscv-cache-extension/paper/fig_speedup.pdf

2

8 | 20

### Shared memory latency (cycles)

012345678

### Speedup over no data cache (×)

break-even

### Speedup

memcpy 16 KiB
FFT N=256
matmul 64x64
conv2d 64x64

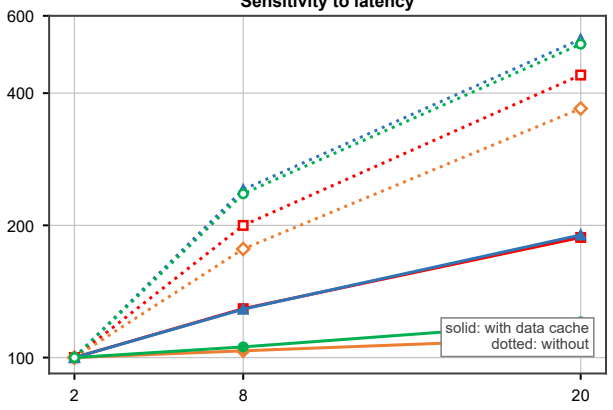
[picture p7: figure]
solid: with data cache dotted: without

### Shared memory latency (cycles)

### Cycles, relative to latency 2 (%)

### Sensitivity to latency
