Krishna-Gorai/riscv-cache-extension/paper/fig_result.pdf

Speedup over no data cache (×)

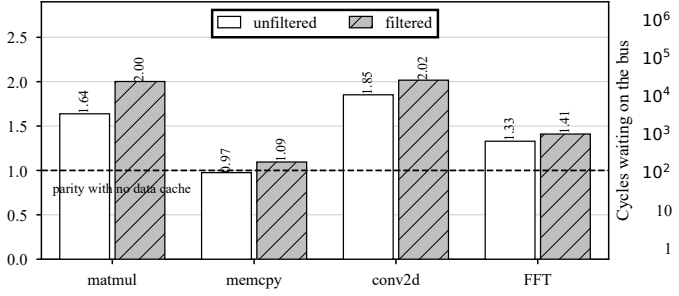
[picture p8: figure]
matmul; memcpy; conv2d; FFT; parity with no data cache; unfiltered; filtered; Cycles waiting on the bus

(a) what the extension is worth
matmul | memcpy | conv2d | FFT
(b) why
unfiltered | filtered
