Krishna-Gorai/riscv-cache-extension/paper/fig_arch.pdf

## Snoopy bus

## Snoop filter (this work)

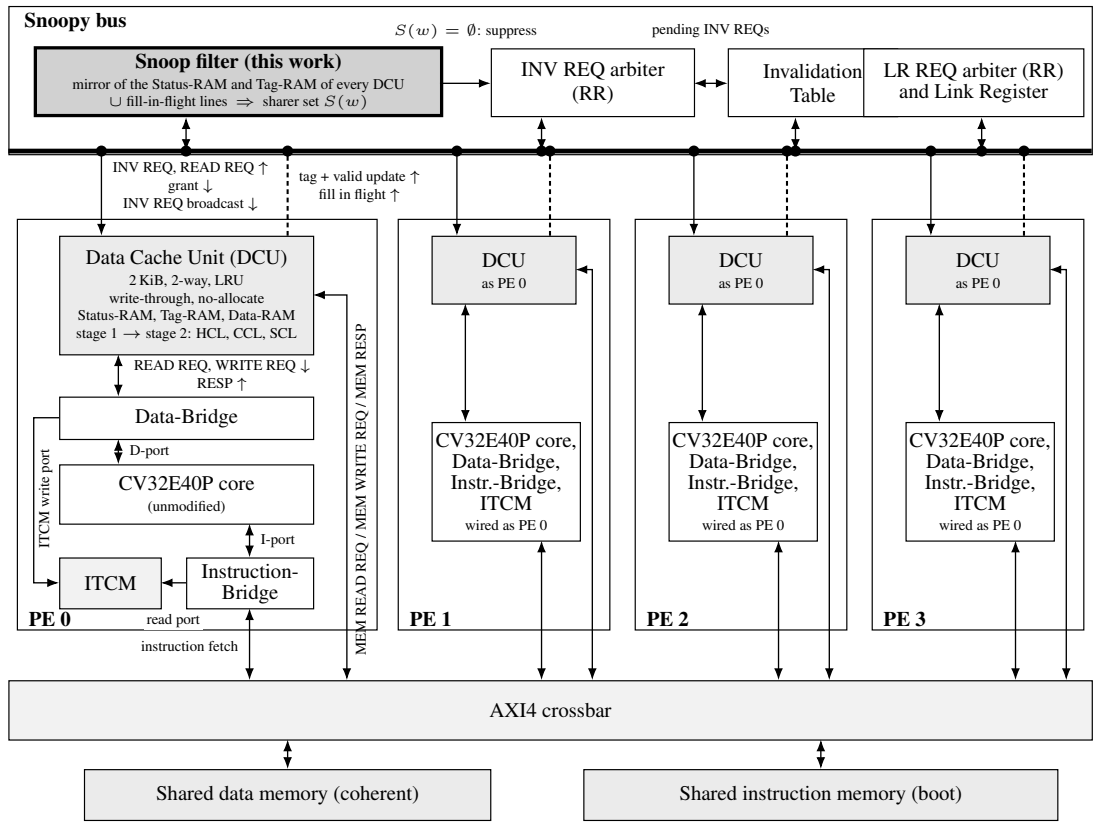
[picture p9: page 1]
Data-Bridge; CV32E40P core; (unmodified); ITCM; Instruction-; Bridge; DCU; RESP ↑; D-port; I-port; read port; instruction fetch; grant ↓; Invalidation Table; S(w) = ∅: suppress; pending INV REQs; AXI4 crossbar; Shared data memory (coherent); Shared instruction memory (boot)

mirror of the Status-RAM and Tag-RAM of every DCU
∪ fill-in-flight lines ⇒ sharer set S(w)

INV REQ arbiter

LR REQ arbiter (RR)
and Link Register

INV REQ, READ REQ ↑

tag + valid update ↑
fill in flight ↑

INV REQ broadcast ↓

Data Cache Unit (DCU)

2 KiB, 2-way, LRU
write-through, no-allocate
Status-RAM, Tag-RAM, Data-RAM
stage 1 → stage 2: HCL, CCL, SCL

MEM READ REQ / MEM WRITE REQ / MEM RESP

READ REQ, WRITE REQ ↓

CV32E40P core,
Data-Bridge,
Instr.-Bridge,
ITCM
wired as PE 0

ITCM write port
