Krishna-Gorai/riscv-cache-extension/paper/fig_filter_col.pdf

## Tag-RAM

mirror | valid tag | valid

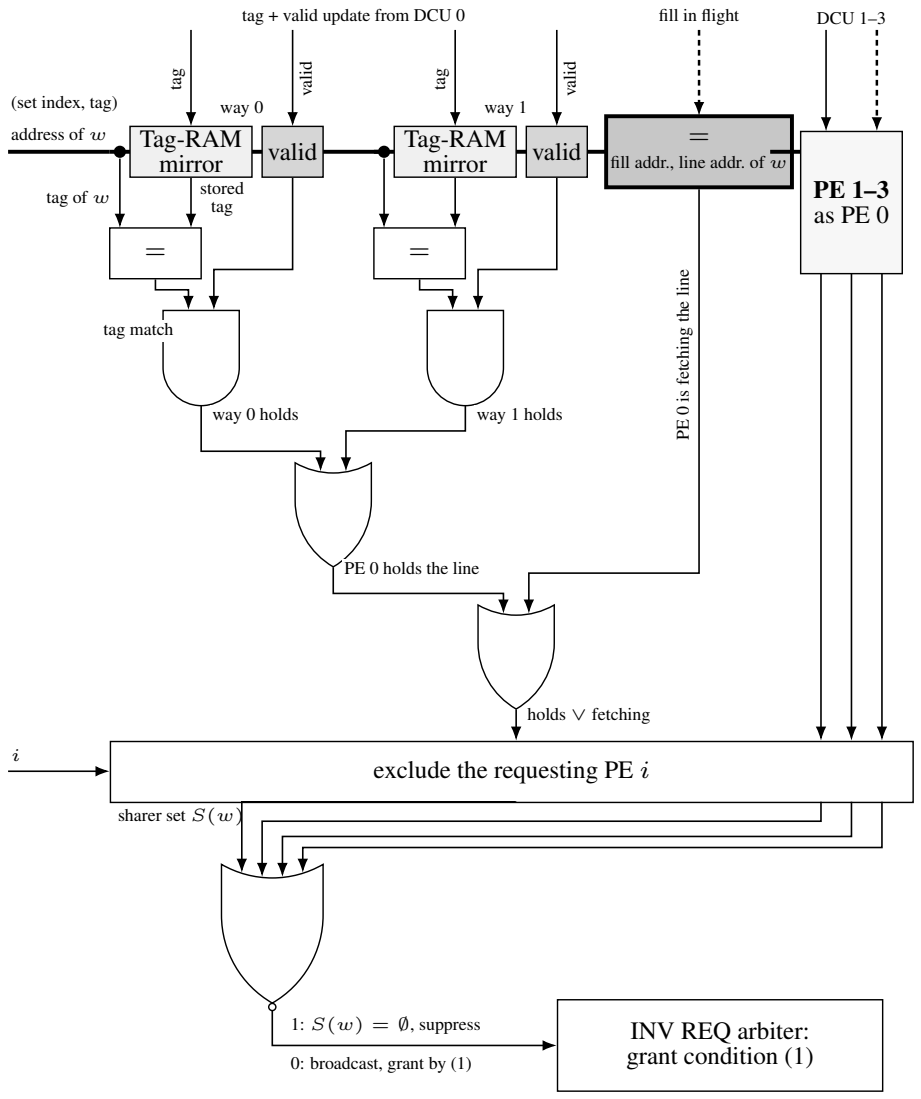
[picture p10: page 1]
address of w; tag + valid update from DCU 0; fill in flight; way 0; Tag-RAM; mirror; valid tag; valid; way 1; tag of w; stored; tag; tag match; way 0 holds; way 1 holds; holds ∨ fetching; DCU 1–3; sharer set S(w); 1: S(w) = ∅, suppress

(set index, tag)

fill addr., line addr. of w

PE 0 is fetching the line

PE 0 holds the line

exclude the requesting PE i

INV REQ arbiter:
grant condition (1)

0: broadcast, grant by (1)
