Krishna-Gorai/riscv-cache-extension/sw/soc_kernels/bench_fft.c

/* ===========================================================================
 *  bench_fft.c -- Fig. 6: radix-2 decimation-in-time FFT, Q15 twiddles.
 *
 *  ONE INDEPENDENT TRANSFORM PER PE. Fig. 6 labels its x-axis "FFT Input Size
 *  per Sample", and that "per Sample" is the whole decomposition: each PE owns
 *  a sample buffer and transforms it end to end. Four PEs run four N-point
 *  transforms, they never touch each other's data, and there is no barrier
 *  inside the timed region.
 *
 *  The earlier version split ONE transform across the PEs, with a barrier at
 *  every stage boundary. That is a defensible way to parallelise an FFT, but
 *  it is not what the figure measures, and it scaled the wrong way: the
 *  stage-boundary invalidations and the log2(N) barriers grew with N, so the
 *  measured reduction FELL from 13.9 % at N=128 to 3.5 % at N=1024 while the
 *  paper reports a roughly flat ~23 %.
 *
 *  Locality still degrades with size -- the butterfly half-span doubles every
 *  stage, so the late stages stride further than a line -- which is the
 *  mechanism behind the paper reporting FFT as its smallest gain. That effect
 *  is real and is kept. What is gone is the cross-PE sharing on top of it.
 *
 *  Every PE transforms the SAME input sequence. Control flow here is
 *  data-independent, so identical inputs change neither the cycle count nor
 *  the hit rate -- but it makes PE0's output block bit-identical to what the
 *  old shared-array version produced, which is a free regression check that
 *  the rewrite changed the decomposition and not the arithmetic.
 *
 *  Fixed point rather than float: CV32E40P here has no F extension.
 *
 *  Every stage is scaled by 1/2. Without that the magnitude doubles per stage
 *  and by N=1024 a twiddle product would leave int32 -- which would not merely
 *  lose accuracy, it would stop the C agreeing with the Python model in
 *  scripts/bench_golden.py, because C wraps where Python does not. With it the
 *  magnitude stays put and one datapath covers 128 through 1024.
 * ======================================================================== */

#include "bench.h"

/* Fig. 6 sweeps the transform over 128, 256, 512 and 1024 points. Size and
 * golden both come from the build, so one source builds every point:
 *   KCFLAGS="-DBENCH_LOG2N=10 -DBENCH_GOLDEN=0x5E33A180u" OUT_SUFFIX=_1024 ...
 * The defaults are the leftmost point of the figure. */
#ifndef BENCH_LOG2N
#define BENCH_LOG2N  7u
#endif
#ifndef BENCH_GOLDEN
#define BENCH_GOLDEN 0x3F6C9A00u
#endif

#define LOG2N    BENCH_LOG2N
#define NPT      (1u << LOG2N)

#define GOLDEN   BENCH_GOLDEN

/* One table serves every transform size. The twiddle a stage needs is
 * W^(k/step), and indexing a 1024-point table at k*(1024/step) gives exactly
 * that angle whatever N is -- so there is no per-size table to keep in step
 * with the Python model. */
#define TWN      1024u

static const int32_t TW[TWN / 2][2] = {
    {  32768,      0 }, {  32767,   -201 }, {  32766,   -402 }, {  32762,   -603 },
    {  32758,   -804 }, {  32753,  -1005 }, {  32746,  -1206 }, {  32738,  -1407 },
    {  32729,  -1608 }, {  32718,  -1809 }, {  32706,  -2009 }, {  32693,  -2210 },
    {  32679,  -2411 }, {  32664,  -2611 }, {  32647,  -2811 }, {  32629,  -3012 },
    {  32610,  -3212 }, {  32590,  -3412 }, {  32568,  -3612 }, {  32546,  -3812 },
    {  32522,  -4011 }, {  32496,  -4211 }, {  32470,  -4410 }, {  32442,  -4609 },
    {  32413,  -4808 }, {  32383,  -5007 }, {  32352,  -5205 }, {  32319,  -5404 },
    {  32286,  -5602 }, {  32251,  -5800 }, {  32214,  -5998 }, {  32177,  -6195 },
    {  32138,  -6393 }, {  32099,  -6590 }, {  32058,  -6787 }, {  32015,  -6983 },
    {  31972,  -7180 }, {  31927,  -7376 }, {  31881,  -7571 }, {  31834,  -7767 },
    {  31786,  -7962 }, {  31737,  -8157 }, {  31686,  -8351 }, {  31634,  -8546 },
    {  31581,  -8740 }, {  31527,  -8933 }, {  31471,  -9127 }, {  31415,  -9319 },
    {  31357,  -9512 }, {  31298,  -9704 }, {  31238,  -9896 }, {  31177, -10088 },
    {  31114, -10279 }, {  31050, -10469 }, {  30986, -10660 }, {  30920, -10850 },
    {  30853, -11039 }, {  30784, -11228 }, {  30715, -11417 }, {  30644, -11605 },
    {  30572, -11793 }, {  30499, -11980 }, {  30425, -12167 }, {  30350, -12354 },
    {  30274, -12540 }, {  30196, -12725 }, {  30118, -12910 }, {  30038, -13095 },
    {  29957, -13279 }, {  29875, -13463 }, {  29792, -13646 }, {  29707, -13828 },
    {  29622, -14010 }, {  29535, -14192 }, {  29448, -14373 }, {  29359, -14553 },
    {  29269, -14733 }, {  29178, -14912 }, {  29086, -15091 }, {  28993, -15269 },
    {  28899, -15447 }, {  28803, -15624 }, {  28707, -15800 }, {  28610, -15976 },
    {  28511, -16151 }, {  28411, -16326 }, {  28311, -16500 }, {  28209, -16673 },
    {  28106, -16846 }, {  28002, -17018 }, {  27897, -17190 }, {  27791, -17361 },
    {  27684, -17531 }, {  27576, -17700 }, {  27467, -17869 }, {  27357, -18037 },
    {  27246, -18205 }, {  27133, -18372 }, {  27020, -18538 }, {  26906, -18703 },
    {  26791, -18868 }, {  26674, -19032 }, {  26557, -19195 }, {  26439, -19358 },
    {  26320, -19520 }, {  26199, -19681 }, {  26078, -19841 }, {  25956, -20001 },
    {  25833, -20160 }, {  25708, -20318 }, {  25583, -20475 }, {  25457, -20632 },
    {  25330, -20788 }, {  25202, -20943 }, {  25073, -21097 }, {  24943, -21251 },
    {  24812, -21403 }, {  24680, -21555 }, {  24548, -21706 }, {  24414, -21856 },
    {  24279, -22006 }, {  24144, -22154 }, {  24008, -22302 }, {  23870, -22449 },
    {  23732, -22595 }, {  23593, -22740 }, {  23453, -22884 }, {  23312, -23028 },
    {  23170, -23170 }, {  23028, -23312 }, {  22884, -23453 }, {  22740, -23593 },
    {  22595, -23732 }, {  22449, -23870 }, {  22302, -24008 }, {  22154, -24144 },
    {  22006, -24279 }, {  21856, -24414 }, {  21706, -24548 }, {  21555, -24680 },
    {  21403, -24812 }, {  21251, -24943 }, {  21097, -25073 }, {  20943, -25202 },
    {  20788, -25330 }, {  20632, -25457 }, {  20475, -25583 }, {  20318, -25708 },
    {  20160, -25833 }, {  20001, -25956 }, {  19841, -26078 }, {  19681, -26199 },
    {  19520, -26320 }, {  19358, -26439 }, {  19195, -26557 }, {  19032, -26674 },
    {  18868, -26791 }, {  18703, -26906 }, {  18538, -27020 }, {  18372, -27133 },
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
};
static inline uint32_t bitrev(uint32_t v) {
    uint32_t r = 0;
    for (uint32_t b = 0; b < LOG2N; b++) { r = (r << 1) | (v & 1u); v >>= 1; }
    return r;
}

int main(void) {
    uint32_t id  = hart_id();
    uint32_t npe = NUM_PES;

    /* This PE's own buffer: RE then IM, 2*NPT words, immediately after the
     * blocks of the lower-numbered PEs. Nothing outside this window is ever
     * read or written by this PE, so no line is ever shared and the snoopy
     * bus stays silent for the whole timed region. */
    uint32_t base = id * 2u * NPT * 4u;
    volatile uint32_t *re = shared_ptr(base);
    volatile uint32_t *im = shared_ptr(base + NPT * 4u);

    uint32_t t0, t1;
    uint32_t tot0 = 0;

    for (uint32_t i = 0; i < NPT; i++) {
        re[i] = (uint32_t)(int32_t)((int32_t)((i * 37u) % 1000u) - 500);
        im[i] = 0u;
    }

    /* The one barrier: it aligns the start so the four measurements cover the
     * same window of contention, not so the algorithm needs it. */
    barrier();

    if (id == 0) tot0 = CYCLE_LO;
    t0 = CYCLE_LO;

    /* --- bit-reversal permutation --------------------------------------- */
    for (uint32_t i = 0; i < NPT; i++) {
        uint32_t j = bitrev(i);
        if (j > i) {
            uint32_t tr = re[i], ti = im[i];
            re[i] = re[j]; im[i] = im[j];
            re[j] = tr;    im[j] = ti;
        }
    }

    /* --- log2(N) butterfly stages, all N/2 butterflies on this PE --------
     *
     * Stage s pairs elements 2^s apart, inside groups of 2^(s+1). So for every
     * stage whose group is no wider than a block, each butterfly reads and
     * writes within ONE block, and blocks are independent of each other until
     * the group outgrows them. That means the early stages can be run block by
     * block -- all of stage 0..log2(B)-1 on block 0, then on block 1 -- with the
     * block staying resident the whole time, instead of stage by stage with
     * every stage streaming all 8N bytes through a cache that cannot hold them.
     *
     * The butterflies are the same butterflies with the same operands, merely
     * in a different order, so the output is bit-identical and the golden
     * checksum is unchanged. Only the late stages, whose span exceeds a block,
     * still sweep the whole array: log2(N/B) of them rather than log2(N).
     *
     * B is a compile-time choice. 128 points is 1 KiB of re+im, half the DCU,
     * which leaves room for the two arrays to sit in different sets rather than
     * fight for the same ones. Unset, the loop is the plain stage-major sweep
     * above, which is what reproduces the reference's kernel.
     * ------------------------------------------------------------------------ */
#ifdef BENCH_FFT_BLOCK
#  define FFT_BLOCK  ((uint32_t)BENCH_FFT_BLOCK)
    {
        /* Early stages, block-major. If N <= B everything is already resident
         * and this degenerates to the plain loop, which is the right answer. */
        uint32_t blk   = (FFT_BLOCK < NPT) ? FFT_BLOCK : NPT;
        uint32_t s_blk = 0;
        while ((1u << (s_blk + 1)) <= blk) s_blk++;   /* stages with step <= blk */

        for (uint32_t b = 0; b < NPT; b += blk) {
            for (uint32_t s = 0; s < s_blk; s++) {
                uint32_t half = 1u << s;
                uint32_t step = half << 1;
                for (uint32_t g = b; g < b + blk; g += step) {
                    for (uint32_t k = 0; k < half; k++) {
                        uint32_t ia = g + k;
                        uint32_t ib = ia + half;
                        int32_t wr = TW[k * (TWN / step)][0];
                        int32_t wi = TW[k * (TWN / step)][1];
                        int32_t br = (int32_t)re[ib], bi = (int32_t)im[ib];
                        int32_t ar = (int32_t)re[ia], ai = (int32_t)im[ia];
                        int32_t tr = (wr * br - wi * bi) >> 15;
                        int32_t ti = (wr * bi + wi * br) >> 15;
                        re[ib] = (uint32_t)((ar - tr) >> 1);
                        im[ib] = (uint32_t)((ai - ti) >> 1);
                        re[ia] = (uint32_t)((ar + tr) >> 1);
                        im[ia] = (uint32_t)((ai + ti) >> 1);
                    }
                }
            }
        }

        /* Late stages, whose span crosses blocks.
         *
         * A butterfly at stage s pairs i with i + 2^s. Once 2^s is a multiple
         * of the block size B, both indices have the same i mod B -- so the
         * late stages never mix columns: they are B independent (N/B)-point
         * FFTs, one per column j = {j, j+B, j+2B, ...}, each with the same
         * butterflies in the same order as the plain sweep would apply to
         * those elements. Running them column by column, with the column held
         * in a small scratch, turns log2(N/B) full sweeps of an array that does
         * not fit the cache into ONE strided read of it plus stage work on
         * N/B resident words.
         *
         * The first late stage reads straight from the array and the last one
         * writes straight back to it, so there is no separate gather or
         * scatter pass and the write count is the same as the plain sweep's.
         * With a single late stage (N = 2B) the two coincide and the scratch is
         * never touched.
         *
         * The twiddle index is the original one: with ia = j + ma*B and ma's
         * group start a multiple of step/B, ia mod step = j + mk*B, which is
         * what the plain loop's k would have been. Same operands, same order,
         * same rounding -- the output is bit-identical and the golden check
         * below is what proves it.
         *
         * Scratch lives in the shared memory, after every PE's buffers, so it
         * goes through the DCU like everything else and the comparison stays
         * honest: a private scratch would take the late stages out of the
         * cache's hands entirely and overstate what the cache is doing. */
        if (s_blk < LOG2N) {
            uint32_t M     = NPT / blk;
            uint32_t sbase = (uint32_t)NUM_PES * 2u * NPT * 4u + id * 2u * M * 4u;
            volatile uint32_t *sr = shared_ptr(sbase);
            volatile uint32_t *si = shared_ptr(sbase + M * 4u);

            for (uint32_t j = 0; j < blk; j++) {
                for (uint32_t s = s_blk; s < LOG2N; s++) {
                    uint32_t half  = 1u << s;
                    uint32_t step  = half << 1;
                    uint32_t hb    = half / blk;       /* half-span, in column units */
                    uint32_t sb    = step / blk;       /* group size, in column units */
                    uint32_t first = (s == s_blk);
                    uint32_t last  = (s + 1u == LOG2N);

                    for (uint32_t mg = 0; mg < M; mg += sb) {
                        for (uint32_t mk = 0; mk < hb; mk++) {
                            uint32_t ma = mg + mk;
                            uint32_t mb = ma + hb;
                            uint32_t k  = j + mk * blk;          /* == ia mod step */
                            int32_t wr = TW[k * (TWN / step)][0];
                            int32_t wi = TW[k * (TWN / step)][1];

                            int32_t ar, ai, br, bi;
                            if (first) {
                                ar = (int32_t)re[j + ma * blk]; ai = (int32_t)im[j + ma * blk];
                                br = (int32_t)re[j + mb * blk]; bi = (int32_t)im[j + mb * blk];
                            } else {
                                ar = (int32_t)sr[ma]; ai = (int32_t)si[ma];
                                br = (int32_t)sr[mb]; bi = (int32_t)si[mb];
                            }

                            int32_t tr = (wr * br - wi * bi) >> 15;
                            int32_t ti = (wr * bi + wi * br) >> 15;
                            uint32_t nbr = (uint32_t)((ar - tr) >> 1);
                            uint32_t nbi = (uint32_t)((ai - ti) >> 1);
                            uint32_t nar = (uint32_t)((ar + tr) >> 1);
                            uint32_t nai = (uint32_t)((ai + ti) >> 1);

                            if (last) {
                                re[j + mb * blk] = nbr; im[j + mb * blk] = nbi;
                                re[j + ma * blk] = nar; im[j + ma * blk] = nai;
                            } else {
                                sr[mb] = nbr; si[mb] = nbi;
                                sr[ma] = nar; si[ma] = nai;
                            }
                        }
                    }
                }
            }
        }
    }
#else
    for (uint32_t s = 0; s < LOG2N; s++) {
        uint32_t half = 1u << s;
        uint32_t step = half << 1;

        for (uint32_t g = 0; g < NPT; g += step) {
            for (uint32_t k = 0; k < half; k++) {
                uint32_t ia = g + k;
                uint32_t ib = ia + half;

                int32_t wr = TW[k * (TWN / step)][0];
                int32_t wi = TW[k * (TWN / step)][1];
                int32_t br = (int32_t)re[ib], bi = (int32_t)im[ib];
                int32_t ar = (int32_t)re[ia], ai = (int32_t)im[ia];

                int32_t tr = (wr * br - wi * bi) >> 15;
                int32_t ti = (wr * bi + wi * br) >> 15;

                re[ib] = (uint32_t)((ar - tr) >> 1);
                im[ib] = (uint32_t)((ai - ti) >> 1);
                re[ia] = (uint32_t)((ar + tr) >> 1);
                im[ia] = (uint32_t)((ai + ti) >> 1);
            }
        }
    }
#endif
    t1 = CYCLE_LO;

    bench_report(id, t1 - t0);
    barrier();

    if (id == 0) {
        /* Every PE's block is scored, so a PE that got its own transform
         * wrong is caught even though the blocks hold the same values. */
        bench_publish(npe, CYCLE_LO - tot0, 0u, npe * 2u * NPT, GOLDEN);
        puts_("fft: n=");     putdec(NPT);
        puts_(" cycles=");    putdec(t1 - t0);
        putch(10);
    }
    return 0;
}
