Krishna-Gorai/riscv-cache-extension/rtl/snoop/snoopy_bus.sv

// =============================================================================
//  snoopy_bus.sv -- scalable snoopy bus unit (Fig. 4)
//
//  Section III-B-b: "The snoopy bus is connected to all Data-Bridges to provide
//  cache coherency. The snoopy bus consists of four main components: two
//  open-source Arbiters, a Link Register and an Invalidation Table. Both
//  Arbiters adopt the Round Robin arbitration strategy. The first Arbiter is
//  responsible for arbitrating the INV REQs and atomic Store-Conditional (SC)
//  WRITE REQs. The second Arbiter, on the other hand, handles the atomic
//  Load-Reserved (LR) READ REQs."
//
//  Behaviour
//    * A core WRITE REQ reaches the bus as an INV REQ. At most one is granted
//      per cycle; on grant the address is broadcast to every other DCU.
//    * A granted INV REQ is only released once every other DCU can accept the
//      broadcast, so an invalidation is never lost.
//    * Plain READ REQs are not arbitrated against each other -- multiple
//      readers may proceed in the same cycle, which is the "Multiple-Readers"
//      half of the MRSW invariant. A READ REQ is withheld while any other core
//      has an INV REQ outstanding for the same line, which is the
//      "Single-Writer" half.
//    * LR READ REQs additionally pass the second arbiter, since there is a
//      single Link Register.
//
//  Note on combinational structure: grants are a function of registered state
//  only (the DCU request registers, the arbiter pointers, the Invalidation
//  Table and the readiness of the other DCUs). The DCUs in turn compute their
//  invalidation readiness without looking at the grant, so no combinational
//  loop is closed across the cluster.
// =============================================================================
module snoopy_bus
  import cache_pkg::*;
#(
  parameter  int unsigned NumCores  = 4,
  parameter  int unsigned AddrW     = 32,
  parameter  int unsigned LineBytes = 16,

  // Snoop filter. 0 broadcasts every invalidation, as published. 1 consults an
  // exact mirror of the DCUs' tag arrays first and sends nothing when no other
  // cache holds the line. See rtl/snoop/snoop_filter.sv for why a mirror rather
  // than a hash, and results/invalidation_use.csv for why it is worth having.
  parameter  bit          SnoopFilter = 1'b0,

  // Directed invalidation. 0 keeps the published broadcast bus: a granted
  // invalidation goes to every other DCU and the grant is held until every
  // other DCU is ready. 1 uses the mirror's per-core sharer vector to drive the
  // invalidation into exactly the caches that hold the line, and to hold the
  // grant on only those -- an exact multicast with a partial barrier.
  //
  // This is what exactness buys that approximation cannot. A conservative
  // filter may over-claim sharers safely, so it can gate an all-or-nothing
  // broadcast; but under multicast a missing sharer bit drops an invalidation
  // that was needed, so only an exact mirror may steer the fan-out. Requires
  // SnoopFilter -- there is no sharer vector without the mirror.
  parameter  bit          DirectedInv = 1'b0,

  // Geometry of the caches being mirrored; ignored when SnoopFilter is 0.
  parameter  int unsigned NumWays   = 2,
  parameter  int unsigned NumSets   = 64,

  localparam int unsigned OffsW = $clog2(LineBytes),
  localparam int unsigned IdxW  = $clog2(NumSets),
  localparam int unsigned TagW  = AddrW - IdxW - OffsW,
  localparam int unsigned WayW  = (NumWays <= 1) ? 1 : $clog2(NumWays),
  localparam int unsigned CoreW = (NumCores <= 1) ? 1 : $clog2(NumCores)
) (
  input  logic                      clk_i,
  input  logic                      rst_ni,

  // --- request channel, one per DCU (driven by its stage 1) ------------------
  input  logic [NumCores-1:0]       req_i,
  input  logic [NumCores-1:0]       is_inv_i,     // 1 = INV REQ, 0 = READ REQ
  input  logic [NumCores*AddrW-1:0] addr_i,
  input  logic [NumCores*2-1:0]     amo_i,        // packed amo_e
  output logic [NumCores-1:0]       gnt_o,
  output logic [NumCores-1:0]       excl_ok_o,

  // --- write-through still in flight, one per DCU ---------------------------
  input  logic [NumCores-1:0]       wr_busy_i,
  input  logic [NumCores*AddrW-1:0] wr_addr_i,

  // --- invalidation broadcast, one per DCU ----------------------------------
  output logic [NumCores-1:0]       inv_valid_o,
  output logic [NumCores*AddrW-1:0] inv_addr_o,
  input  logic [NumCores-1:0]       inv_ready_i,

  // --- snoop-filter mirror updates, one per DCU -----------------------------
  input  logic [NumCores-1:0]       dir_upd_i,
  input  logic [NumCores*IdxW-1:0]  dir_set_i,
  input  logic [NumCores*WayW-1:0]  dir_way_i,
  input  logic [NumCores*TagW-1:0]  dir_tag_i,
  input  logic [NumCores-1:0]       dir_inst_i,

  // --- refill in flight, one per DCU ----------------------------------------
  // The other half of "who has to hear this". See the note on bcast_tgt.
  input  logic [NumCores-1:0]       fill_busy_i,
  input  logic [NumCores*AddrW-1:0] fill_addr_i
);

  function automatic logic same_line(input logic [AddrW-1:0] a,
                                     input logic [AddrW-1:0] b);
    return a[AddrW-1:OffsW] == b[AddrW-1:OffsW];
  endfunction

  // ---------------------------------------------------------------------------
  //  Request classification
  // ---------------------------------------------------------------------------
  logic [NumCores-1:0] is_write, is_read, is_lr, is_sc;

  // The qualifier is only ever compared, so the raw slice off the packed bus
  // is matched against the enum values directly rather than cast first.
  always @(*) begin
    for (int unsigned c = 0; c < NumCores; c++) begin
      is_write[c] = req_i[c] &&  is_inv_i[c];
      is_read[c]  = req_i[c] && !is_inv_i[c];
      is_lr[c]    = is_read[c]  && (amo_i[c*2 +: 2] == AMO_LR);
      is_sc[c]    = is_write[c] && (amo_i[c*2 +: 2] == AMO_SC);
    end
  end

  // ---------------------------------------------------------------------------
  //  Arbiter 1 -- INV REQs and atomic SC WRITE REQs
  // ---------------------------------------------------------------------------
  logic [NumCores-1:0] inv_arb_gnt;
  logic                inv_arb_valid;
  logic [CoreW-1:0]    inv_arb_idx;
  logic                inv_gnt_valid;

  // A line whose write-through is still in flight is locked against another
  // writer as well: that is the Single-Writer half of the MRSW invariant.
  logic [NumCores-1:0] write_blocked;

  always @(*) begin
    for (int unsigned w = 0; w < NumCores; w++) begin
      write_blocked[w] = 1'b0;
      for (int unsigned c = 0; c < NumCores; c++) begin
        if (c != w && wr_busy_i[c] &&
            same_line(wr_addr_i[c*AddrW +: AddrW], addr_i[w*AddrW +: AddrW])) begin
          write_blocked[w] = 1'b1;
        end
      end
    end
  end

  rr_arbiter #(.NumReq(NumCores)) u_inv_arb (
    .clk_i       (clk_i),
    .rst_ni      (rst_ni),
    .req_i       (is_write & ~write_blocked),
    .update_i    (inv_gnt_valid),
    .gnt_o       (inv_arb_gnt),
    .gnt_valid_o (inv_arb_valid),
    .gnt_idx_o   (inv_arb_idx)
  );

  logic [AddrW-1:0] win_addr;
  logic             win_is_sc;
  logic             sc_excl_ok;
  logic             bcast_needed;
  logic             others_ready;

  assign win_addr  = addr_i[inv_arb_idx*AddrW +: AddrW];
  assign win_is_sc = is_sc[inv_arb_idx];

  // ---------------------------------------------------------------------------
  //  Snoop filter -- is there anybody to tell?
  //
  //  The mirror is exact about what each cache holds, but "holds" is not the
  //  property the bus needs. A cache with a refill in flight holds nothing for
  //  the line and still has to hear the invalidation. So the mirror answers
  //  half the question here and filling_line below answers the other half; only
  //  their union, any_sharer, is safe to gate a broadcast on.
  //
  //  Held high when the filter is not built, so bcast_needed keeps its
  //  published meaning and the two designs differ in one parameter.
  // ---------------------------------------------------------------------------
  // Driven from inside a generate branch, so it is declared as a wire with an
  // explicit default rather than a variable: a variable left undriven in the
  // branch that is not taken reads as X, and an X here propagates straight into
  // bcast_needed and quietly changes what the bus does.
  logic filt_from_mirror;

  // Per-core sharer vector, the requester's own bit already cleared by the
  // mirror. Defaults to "everybody" when there is no mirror to ask, so that a
  // build without the filter keeps the published fan-out exactly.
  wire  [NumCores-1:0] filt_held;
  logic [NumCores-1:0] filt_held_mirror;

  if (DirectedInv && !SnoopFilter) begin : g_bad_cfg
    initial $fatal(1, "snoopy_bus: DirectedInv requires SnoopFilter");
  end

  if (SnoopFilter) begin : g_filter
    snoop_filter #(
      .NumCores (NumCores),
      .NumWays  (NumWays),
      .NumSets  (NumSets),
      .AddrW    (AddrW),
      .OffsW    (OffsW)
    ) u_filter (
      .clk_i       (clk_i),
      .rst_ni      (rst_ni),
      .upd_valid_i (dir_upd_i),
      .upd_set_i   (dir_set_i),
      .upd_way_i   (dir_way_i),
      .upd_tag_i   (dir_tag_i),
      .upd_inst_i  (dir_inst_i),
      .qry_addr_i  (win_addr),
      .qry_core_i  (inv_arb_idx),
      .held_o      (filt_held_mirror),
      .any_other_o (filt_from_mirror)
    );
  end else begin : g_no_filter
    assign filt_from_mirror = 1'b1;
    assign filt_held_mirror = {NumCores{1'b1}};
  end

  // One driver, at module scope, so there is no doubt what this is when the
  // filter is not built.
  assign filt_held      = SnoopFilter ? filt_held_mirror : {NumCores{1'b1}};

  // ---------------------------------------------------------------------------
  //  Caches that do not hold the line yet, but are about to.
  //
  //  A DCU between its MEM READ REQ and its refill holds nothing for the line,
  //  so the tag mirror -- which is exact about committed state -- reports it as
  //  not a sharer. It is nonetheless the cache that most needs the
  //  invalidation: receiving one in that window is what cancels its refill
  //  ("special case 2" in dcu.sv). Suppressing or steering around it lets it
  //  install a line that was invalidated while in flight.
  //
  //  So the filter's answer is residency OR imminent residency. This term is
  //  what makes the mirror exact with respect to the property that actually
  //  matters, and it is required for plain suppression as much as for directed
  //  invalidation: the empty-sharer-set case is wrong in precisely the same way
  //  when the set looks empty only because a fill has not landed yet.
  // ---------------------------------------------------------------------------
  logic [NumCores-1:0] filling_line;

  always @(*) begin
    for (int unsigned c = 0; c < NumCores; c++) begin
`ifdef NO_FILL_TERM
      // Deliberately unsound: the committed-tag mirror of the first design,
      // kept behind a define so that the assertions of tb/sva/filter_sva.sv can
      // be shown to fail on it. Never define this in a real build.
      filling_line[c] = 1'b0;
`else
      filling_line[c] = fill_busy_i[c] &&
                        same_line(fill_addr_i[c*AddrW +: AddrW], win_addr);
`endif
    end
  end

  // The complete sharer set: holds it, or is fetching it. The requester is
  // never in it.
  logic [NumCores-1:0] sharers;
  logic                any_sharer;

  always @(*) begin
    for (int unsigned c = 0; c < NumCores; c++) begin
      sharers[c] = (filt_held[c] || filling_line[c]) &&
                   (int'(inv_arb_idx) != c);
    end
  end

  assign any_sharer = SnoopFilter ? (|sharers) : 1'b1;

  // A store-conditional that lost its reservation performs no write, so it
  // needs no invalidation broadcast -- it is granted purely to release the
  // requesting DCU's stage 1.
  assign bcast_needed = inv_arb_valid && !(win_is_sc && !sc_excl_ok)
                        && any_sharer
`ifdef ORACLE_NOBCAST
    // -------------------------------------------------------------------------
    //  MEASUREMENT INSTRUMENT. NOT A DESIGN. Never define this for a build.
    //
    //  An oracle snoop filter: assume no other cache holds the line, so send no
    //  broadcast and do not wait for the other DCUs to be ready to accept one.
    //  Arbitration and the write-busy lock are deliberately left alone -- the
    //  lock still has to stop a remote read fetching a pre-write value from
    //  memory, whoever is caching what.
    //
    //  This is only sound where no invalidation would have been useful, which
    //  results/invalidation_use.csv says is the case for every kernel here:
    //  1,048,821 broadcasts, none of which cleared a line. If a benchmark that
    //  passes without this define fails with it, that assumption was wrong for
    //  that benchmark, and the failure is the useful result.
    //
    //  It bounds what a real snoop filter could return before one is built.
    // -------------------------------------------------------------------------
    && 1'b0
`endif
    ;

  // ---------------------------------------------------------------------------
  //  Which DCUs a granted invalidation must actually reach.
  //
  //  Published behaviour is every other DCU. With DirectedInv it is exactly the
  //  DCUs the mirror says hold the line, which is a subset -- often empty, in
  //  which case bcast_needed is already low and this is all zero anyway.
  //
  //  The requester is excluded explicitly as well as by the mirror: a core
  //  never invalidates its own copy through the bus, it updates or drops that
  //  itself, and the guard has to hold on the un-mirrored path too.
  // ---------------------------------------------------------------------------
  logic [NumCores-1:0] bcast_tgt;

  always @(*) begin
    for (int unsigned c = 0; c < NumCores; c++) begin
      bcast_tgt[c] = bcast_needed && (int'(inv_arb_idx) != c) &&
                     (!DirectedInv || sharers[c]);
    end
  end

  // The grant now waits only on the DCUs that are actually being told. A DCU
  // that does not hold the line has nothing to accept, so making the writer
  // wait for it was the serialisation this work removes.
  always @(*) begin
    others_ready = 1'b1;
    for (int unsigned c = 0; c < NumCores; c++) begin
      if (bcast_tgt[c] && !inv_ready_i[c]) others_ready = 1'b0;
    end
  end

  assign inv_gnt_valid = inv_arb_valid && (!bcast_needed || others_ready);

  // ---------------------------------------------------------------------------
  //  Invalidation Table -- INV REQs asserted but not granted
  // ---------------------------------------------------------------------------
  logic [NumCores-1:0]       tbl_valid;
  logic [NumCores*AddrW-1:0] tbl_addr;
  logic [NumCores-1:0]       inv_gnt_vec;

  assign inv_gnt_vec = inv_arb_gnt & {NumCores{inv_gnt_valid}};

  invalidation_table #(
    .NumCores (NumCores),
    .AddrW    (AddrW)
  ) u_inv_table (
    .clk_i         (clk_i),
    .rst_ni        (rst_ni),
    .inv_req_i     (is_write),
    .inv_addr_i    (addr_i),
    .inv_gnt_i     (inv_gnt_vec),
    .entry_valid_o (tbl_valid),
    .entry_addr_o  (tbl_addr)
  );

  // ---------------------------------------------------------------------------
  //  READ REQ screening -- the Single-Writer half of the MRSW lock
  // ---------------------------------------------------------------------------
  logic [NumCores-1:0] read_blocked;

  always @(*) begin
    for (int unsigned r = 0; r < NumCores; r++) begin
      read_blocked[r] = 1'b0;
      for (int unsigned c = 0; c < NumCores; c++) begin
        if (c != r && tbl_valid[c] &&
            same_line(tbl_addr[c*AddrW +: AddrW], addr_i[r*AddrW +: AddrW])) begin
          read_blocked[r] = 1'b1;
        end
      end
      // An invalidation granted in this very cycle locks the line as well.
      //
      // Deliberately NOT restricted to bcast_tgt. This lock protects a reader
      // from fetching the pre-write value out of shared memory, which has
      // nothing to do with whether that reader currently caches the line -- a
      // core with no copy at all is precisely the one that would miss, go to
      // memory and cache a stale word. Narrowing this to the sharer set would
      // pass every functional test and be wrong, in the same way the
      // hit-speculative bypass was.
      if (inv_gnt_valid && bcast_needed && (int'(inv_arb_idx) != r) &&
          same_line(win_addr, addr_i[r*AddrW +: AddrW])) begin
        read_blocked[r] = 1'b1;
      end
      // and the lock is only released once the write-through has actually
      // reached the shared memory, otherwise this read would fetch and cache
      // the pre-write value with no invalidation left to correct it
      for (int unsigned c = 0; c < NumCores; c++) begin
        if (c != r && wr_busy_i[c] &&
            same_line(wr_addr_i[c*AddrW +: AddrW], addr_i[r*AddrW +: AddrW])) begin
          read_blocked[r] = 1'b1;
        end
      end
    end
  end

`ifndef SYNTHESIS
  // ---------------------------------------------------------------------------
  //  Measurement only: how much of the read stall is false sharing?
  //
  //  Every screening condition above compares whole lines, so a reader is
  //  blocked by a writer that touches any word of the same 16-byte line --
  //  including a word it never reads. That is false sharing, and it is
  //  indistinguishable from true sharing in the cycle counters, which only know
  //  that a read waited.
  //
  //  This recomputes the identical three conditions at word granularity and
  //  counts the difference. A cycle counted in dbg_rd_false is a cycle a reader
  //  spent blocked by a writer it did not actually share a word with -- stall
  //  that a finer invalidation granularity would remove, and stall that the
  //  present design cannot.
  //
  //  Simulation only. It exists to size an opportunity, not to be synthesised,
  //  and it must not influence read_blocked.
  // ---------------------------------------------------------------------------
  function automatic logic same_word(input logic [AddrW-1:0] a,
                                     input logic [AddrW-1:0] b);
    return a[AddrW-1:2] == b[AddrW-1:2];
  endfunction

  logic [NumCores-1:0] read_blocked_word;

  always @(*) begin
    for (int unsigned r = 0; r < NumCores; r++) begin
      read_blocked_word[r] = 1'b0;
      for (int unsigned c = 0; c < NumCores; c++) begin
        if (c != r && tbl_valid[c] &&
            same_word(tbl_addr[c*AddrW +: AddrW], addr_i[r*AddrW +: AddrW])) begin
          read_blocked_word[r] = 1'b1;
        end
      end
      if (inv_gnt_valid && bcast_needed && (int'(inv_arb_idx) != r) &&
          same_word(win_addr, addr_i[r*AddrW +: AddrW])) begin
        read_blocked_word[r] = 1'b1;
      end
      for (int unsigned c = 0; c < NumCores; c++) begin
        if (c != r && wr_busy_i[c] &&
            same_word(wr_addr_i[c*AddrW +: AddrW], addr_i[r*AddrW +: AddrW])) begin
          read_blocked_word[r] = 1'b1;
        end
      end
    end
  end

  int unsigned dbg_rd_blocked;   // core-cycles a pending read was blocked
  int unsigned dbg_rd_false;     // of those, blocked only by line granularity

  always_ff @(posedge clk_i or negedge rst_ni) begin
    if (!rst_ni) begin
      dbg_rd_blocked <= 0;
      dbg_rd_false   <= 0;
    end else begin
      for (int unsigned r = 0; r < NumCores; r++) begin
        // Only count a core that actually has a read outstanding; a blocked
        // signal for a core that is not asking costs nobody anything.
        if (is_read[r] && read_blocked[r]) begin
          dbg_rd_blocked <= dbg_rd_blocked + 1;
          if (!read_blocked_word[r]) dbg_rd_false <= dbg_rd_false + 1;
        end
      end
    end
  end

  final begin
    if (dbg_rd_blocked != 0) begin
      $display(" FALSESHARE blocked=%0d false=%0d pct=%0.2f",
               dbg_rd_blocked, dbg_rd_false,
               100.0 * real'(dbg_rd_false) / real'(dbg_rd_blocked));
    end else begin
      $display(" FALSESHARE blocked=0 false=0 pct=0.00");
    end
  end

  // ---------------------------------------------------------------------------
  //  Measurement only: how often would a committed-tag mirror alone be wrong?
  //
  //  dbg_fill_saved counts granted invalidations where no other cache HOLDS the
  //  line but at least one is FETCHING it. Those are exactly the cases a filter
  //  built on the tag mirror alone would have suppressed -- or, under directed
  //  invalidation, steered away from -- leaving that cache to install a line
  //  that had already been invalidated.
  //
  //  This is not a tuning statistic. A non-zero value here is a count of the
  //  times the mirror-only design would have violated coherence, so it is the
  //  evidence that the fill-in-flight term is load-bearing rather than
  //  defensive. It is reported alongside the total for scale.
  // ---------------------------------------------------------------------------
  int unsigned dbg_inv_granted;  // invalidations granted with a real fan-out
  int unsigned dbg_fill_saved;   // of those, held only by a fill in flight

  logic [NumCores-1:0] held_masked;
  always @(*) begin
    for (int unsigned c = 0; c < NumCores; c++) begin
      held_masked[c] = filt_held[c] && (int'(inv_arb_idx) != c);
    end
  end

  always_ff @(posedge clk_i or negedge rst_ni) begin
    if (!rst_ni) begin
      dbg_inv_granted <= 0;
      dbg_fill_saved  <= 0;
    end else if (inv_gnt_valid && bcast_needed) begin
      dbg_inv_granted <= dbg_inv_granted + 1;
      if (!(|held_masked)) begin
        dbg_fill_saved <= dbg_fill_saved + 1;
        // Announce it, with the time and the address. This case is what makes
        // the filter correct rather than merely fast, and it is rare -- of the
        // order of one in two hundred granted invalidations -- so a waveform
        // showing it is worth being able to jump straight to instead of
        // hunting for. Simulation only, like the counters it sits with.
        $display("  FILLRACE t=%0t core%0d addr=%08x -> broadcast kept alive by a fill in flight (mirror said nobody holds it)",
                 $time, inv_arb_idx, win_addr);
      end
    end
  end

  final begin
    $display(" FILLRACE granted=%0d saved_by_fill_term=%0d",
             dbg_inv_granted, dbg_fill_saved);
  end

`ifdef FILTER_TRACE
  // ---------------------------------------------------------------------------
  //  One line per arbitration outcome, for finding somewhere to look in a
  //  waveform. Off by default: on a benchmark kernel this is a million lines.
  //
  //  SUPPRESS is the speedup -- granted with no broadcast and no barrier.
  //  BCAST    is the cost that remains -- the grant waits for the sharers.
  //  WAIT     is a writer holding the arbiter while the sharers catch up.
  // ---------------------------------------------------------------------------
  always_ff @(posedge clk_i) begin
    if (rst_ni && inv_arb_valid) begin
      if (inv_gnt_valid && !bcast_needed) begin
        $display("TRACE %0t SUPPRESS core%0d addr=%08x held=%04b fill=%04b",
                 $time, inv_arb_idx, win_addr, held_masked, filling_line);
      end else if (inv_gnt_valid && bcast_needed) begin
        $display("TRACE %0t BCAST    core%0d addr=%08x held=%04b fill=%04b tgt=%04b",
                 $time, inv_arb_idx, win_addr, held_masked, filling_line, bcast_tgt);
      end else begin
        $display("TRACE %0t WAIT     core%0d addr=%08x tgt=%04b ready=%04b",
                 $time, inv_arb_idx, win_addr, bcast_tgt, inv_ready_i);
      end
    end
  end
`endif
`endif

  // ---------------------------------------------------------------------------
  //  Arbiter 2 -- atomic LR READ REQs
  // ---------------------------------------------------------------------------
  logic [NumCores-1:0] lr_req;
  logic [NumCores-1:0] lr_arb_gnt;
  logic                lr_arb_valid;
  logic [CoreW-1:0]    lr_arb_idx;

  assign lr_req = is_lr & ~read_blocked;

  rr_arbiter #(.NumReq(NumCores)) u_lr_arb (
    .clk_i       (clk_i),
    .rst_ni      (rst_ni),
    .req_i       (lr_req),
    .update_i    (lr_arb_valid),
    .gnt_o       (lr_arb_gnt),
    .gnt_valid_o (lr_arb_valid),
    .gnt_idx_o   (lr_arb_idx)
  );

  // ---------------------------------------------------------------------------
  //  Link Register
  // ---------------------------------------------------------------------------
  link_register #(
    .NumCores  (NumCores),
    .AddrW     (AddrW),
    .LineBytes (LineBytes)
  ) u_link_reg (
    .clk_i        (clk_i),
    .rst_ni       (rst_ni),
    .lr_set_i     (lr_arb_valid),
    .lr_core_i    (lr_arb_idx),
    .lr_addr_i    (addr_i[lr_arb_idx*AddrW +: AddrW]),
    // Also deliberately NOT restricted to bcast_tgt: a reservation must break
    // whether or not the reserving core still has the line cached. LR takes a
    // reservation, and the line can be evicted under it by ordinary capacity
    // pressure without releasing it; steering this by cache residency would
    // let an SC succeed over a remote write.
    .inv_set_i    (inv_gnt_valid && bcast_needed),
    .inv_addr_i   (win_addr),
    .sc_core_i    (inv_arb_idx),
    .sc_addr_i    (win_addr),
    .sc_excl_ok_o (sc_excl_ok),
    .sc_clear_i   (inv_gnt_valid && win_is_sc),
    .excl_bit_o   (/* unused */)
  );

  // ---------------------------------------------------------------------------
  //  Grants and broadcast
  // ---------------------------------------------------------------------------
  always @(*) begin
    for (int unsigned c = 0; c < NumCores; c++) begin
      if (is_write[c]) begin
        gnt_o[c] = inv_gnt_vec[c];
      end else if (is_read[c]) begin
        gnt_o[c] = !read_blocked[c] && (!is_lr[c] || lr_arb_gnt[c]);
      end else begin
        gnt_o[c] = 1'b0;
      end

      // Only the requesting core of an SC needs the exclusive answer, and it
      // samples it in the cycle its request is granted.
      excl_ok_o[c] = (int'(inv_arb_idx) == c) ? sc_excl_ok : 1'b0;
    end
  end

  always @(*) begin
    inv_valid_o = '0;
    inv_addr_o  = '0;
    for (int unsigned c = 0; c < NumCores; c++) begin
      if (inv_gnt_valid && bcast_tgt[c]) begin
        inv_valid_o[c]                = 1'b1;
        inv_addr_o[c*AddrW +: AddrW]  = win_addr;
      end
    end
  end

endmodule
