Krishna-Gorai/riscv-cache-extension/tb/system/tb_bench.sv

// =============================================================================
//  tb_bench.sv -- the M6 benchmark harness (Figs. 5, 6 and 7)
//
//  One harness for every benchmark kernel, coherent and non-coherent. It does
//  not know which kernel it is running: the kernel publishes a results block
//  (sw/lib/bench.h) naming the region it computed into and the golden checksum
//  that region must hash to, and the harness scores the run from that.
//
//  The checking lives HERE rather than in the kernel on purpose. A kernel that
//  verified itself would only be confirming that it agrees with itself; the
//  golden constants come from scripts/bench_golden.py, an independent Python
//  model. Keeping the check out of the kernel also keeps the DCU hit-rate
//  counters clean -- no verification traffic is folded into the Fig. 7 numbers.
//
//    tb_bench     the coherent SoC  -- private DCUs and the snoopy bus
//    tb_bench_nc  the non-coherent baseline -- no data cache at all
//
//  Run with:  sim/run_xsim.ps1 -Tb tb_bench    -Hex <abs>/sw/build/soc_bench_fft.hex
//             sim/run_xsim.ps1 -Tb tb_bench_nc -Hex <abs>/sw/build/soc_bench_fft.hex
// =============================================================================
`timescale 1ns/1ps

module bench_harness #(
  parameter bit          Coherent = 1'b1,
  parameter string       Label    = "coherent",
  parameter int unsigned MemLat   = 2,
  // Cache geometry. The defaults are the paper's 2 KiB 2-way; the sweeps
  // below vary them to separate a capacity miss from a conflict miss.
  parameter int unsigned NumWays  = 2,
  parameter int unsigned NumSets  = 64,
  // Snoop filter; see rtl/snoop/snoop_filter.sv.
  parameter bit          SnoopFilter = 1'b0,
  parameter bit          DirectedInv = 1'b0
);

  import cache_pkg::*;

  localparam int unsigned NumPes    = 4;
  localparam int unsigned AddrW     = 32;
  localparam int unsigned DataW     = 32;
  localparam int unsigned LineBytes = 16;
  localparam int unsigned SdmemSize = 262144;

  localparam time CLK_P = 10ns;

  // The results block, mirrored from sw/lib/bench.h. Parked at the top of the
  // 256 KiB shared data memory, because the paper's largest configuration is a
  // 128x128 matrix multiply and its three matrices occupy 192 KiB below it.
  localparam int unsigned RES_WORD    = 32'h3F000 >> 2;
  localparam int unsigned BR_CYCLES   = 0;
  localparam int unsigned BR_STATUS   = 8;
  localparam int unsigned BR_RES_OFF  = 16;
  localparam int unsigned BR_RES_WRDS = 17;
  localparam int unsigned BR_GOLDEN   = 18;
  localparam int unsigned BR_SENTINEL = 19;
  localparam int unsigned BR_TOTCYC   = 20;
  localparam int unsigned BR_NPE      = 21;

  localparam logic [31:0] SENTINEL = 32'h00C0FFEE;

  logic clk      = 1'b0;
  logic rst_n    = 1'b0;
  logic fetch_en = 1'b0;
  always #(CLK_P/2) clk = ~clk;

  logic [NumPes-1:0]       done;
  logic [NumPes*DataW-1:0] exit_code;
  logic                    pc_valid;
  logic [7:0]              pc_data;
  logic [31:0]             cycle;
  logic [NumPes-1:0]       core_sleep;

  logic [NumPes*32-1:0]    p_rd_hit, p_rd_miss, p_wr_hit, p_wr_miss;
  logic [NumPes*32-1:0]    p_busy, p_stall_snoop, p_stall_s2, p_rd_wait, p_wr_wait;

  soc_top #(
    .NumPes     (NumPes),
    .Coherent   (Coherent),
    .SnoopFilter (SnoopFilter),
    .DirectedInv (DirectedInv),
    .NumWays    (NumWays),
    .NumSets    (NumSets),
    .LineBytes  (LineBytes),
    .AddrW      (AddrW),
    .DataW      (DataW),
    .ItcmBytes  (32768),
    .SimemBytes (32768),
    .SdmemBytes (SdmemSize),
    .BootAddr   (32'h2000_0000),
    .MemLat     (MemLat)
  ) u_soc (
    .clk_i           (clk),
    .rst_ni          (rst_n),
    .fetch_enable_i  (fetch_en),

    .done_o          (done),
    .exit_code_o     (exit_code),
    .putchar_valid_o (pc_valid),
    .putchar_data_o  (pc_data),
    .cycle_o         (cycle),
    .core_sleep_o    (core_sleep),

    .perf_rd_hit_o   (p_rd_hit),
    .perf_rd_miss_o  (p_rd_miss),
    .perf_wr_hit_o   (p_wr_hit),
    .perf_wr_miss_o  (p_wr_miss),

    .perf_busy_o        (p_busy),
    .perf_stall_snoop_o (p_stall_snoop),
    .perf_stall_s2_o    (p_stall_s2),
    .perf_rd_wait_o     (p_rd_wait),
    .perf_wr_wait_o     (p_wr_wait)
  );

  // --- console ---------------------------------------------------------------
  always_ff @(posedge clk) begin
    if (rst_n && pc_valid) $write("%c", pc_data);
  end

  // ---------------------------------------------------------------------------
  //  Scoreboard
  // ---------------------------------------------------------------------------
  int unsigned errors = 0;
  int unsigned checks = 0;

  function automatic void chk(input bit cond, input string msg);
    checks++;
    if (!cond) begin
      errors++;
      $error("[%0t] CHECK FAILED: %s", $time, msg);
    end
  endfunction

  function automatic logic [31:0] res(input int unsigned idx);
    return u_soc.u_sdmem.peek(RES_WORD + idx);
  endfunction

  // The checksum of sw/lib/bench.h and scripts/bench_golden.py. Change all
  // three together or none of them.
  function automatic logic [31:0] csum(input int unsigned word0,
                                       input int unsigned n);
    logic [31:0] h;
    h = 32'd0;
    for (int unsigned i = 0; i < n; i++)
      h = h * 32'd31 + u_soc.u_sdmem.peek(word0 + i);
    return h;
  endfunction

  // Coherence traffic that told nobody anything: broadcasts received across the
  // cluster against broadcasts that actually cleared a line.
  //
  // Bound through a generate loop rather than read directly in the final block:
  // a hierarchical path into a generate array needs a constant index, and a
  // procedural loop variable is not one.
`ifndef SYNTHESIS
  logic [31:0] inv_rx_w  [NumPes];
  logic [31:0] inv_use_w [NumPes];

  if (Coherent) begin : g_invuse
    for (genvar p = 0; p < NumPes; p++) begin : g_pe
      assign inv_rx_w[p]  = u_soc.g_dcache.u_dcache.g_dcu[p].u_dcu.dbg_inv_rx;
      assign inv_use_w[p] = u_soc.g_dcache.u_dcache.g_dcu[p].u_dcu.dbg_inv_useful;
    end
  end

  final begin
    automatic longint unsigned rx = 0;
    automatic longint unsigned useful = 0;
    if (Coherent) begin
      for (int unsigned p = 0; p < NumPes; p++) begin
        rx     += inv_rx_w[p];
        useful += inv_use_w[p];
      end
      $display(" INVUSE %s rx=%0d useful=%0d pct=%0.2f", Label, rx, useful,
               (rx == 0) ? 0.0 : 100.0 * real'(useful) / real'(rx));
    end
  end
`endif

  string hexfile;

  initial begin
    logic [31:0] sentinel, golden, got, res_off, res_words, npe, totcyc;
    int unsigned kcyc_max;

    if (!$value$plusargs("HEX=%s", hexfile)) hexfile = "program.hex";
    $display("\n=== %s SoC: %0d PEs ===", Label, NumPes);
    $display("--- loading shared instruction memory from %s ---", hexfile);
    $readmemh(hexfile, u_soc.u_simem.mem);

    repeat (10) @(posedge clk);
    rst_n = 1'b1;
    repeat (5) @(posedge clk);
    fetch_en = 1'b1;

    $display("--- running ------------------------------------------------------");
    wait (&done);
    repeat (20) @(posedge clk);

    // ---- what the kernel published -----------------------------------------
    sentinel  = res(BR_SENTINEL);
    res_off   = res(BR_RES_OFF);
    res_words = res(BR_RES_WRDS);
    golden    = res(BR_GOLDEN);
    npe       = res(BR_NPE);
    totcyc    = res(BR_TOTCYC);

    $display("\n--- results (%s) --------------------------------------------", Label);

    chk(sentinel == SENTINEL,
        $sformatf("PE0 published its results block, got %08x expected %08x",
                  sentinel, SENTINEL));

    // Everything below reads the published block, so stop if it is not there:
    // a checksum over a region named by a garbage offset says nothing.
    if (sentinel !== SENTINEL) begin
      $display(" %s FAILED  (%0d errors / %0d checks) -- no results block\n",
               Label, errors, checks);
      $fatal(1);
    end

    chk(npe == NumPes,
        $sformatf("all %0d PEs took part, kernel saw %0d", NumPes, npe));

    for (int unsigned p = 0; p < NumPes; p++) begin
      chk(exit_code[p*DataW +: DataW] == 32'd1,
          $sformatf("PE%0d reported success, got %0d",
                    p, exit_code[p*DataW +: DataW]));
      chk(res(BR_STATUS + p) == 32'd1,
          $sformatf("PE%0d reached the end of its slice, status %0d",
                    p, res(BR_STATUS + p)));
    end

    // ---- the result itself --------------------------------------------------
    got = csum(res_off >> 2, res_words);
    chk(got == golden,
        $sformatf("checksum over %0d words at 0x%05x = %08x, expected %08x",
                  res_words, res_off, got, golden));

    // ---- Fig. 5 / 6: what it cost -------------------------------------------
    kcyc_max = 0;
    $display("\n per-PE kernel cycles:");
    for (int unsigned p = 0; p < NumPes; p++) begin
      $display("  PE%0d  %0d", p, res(BR_CYCLES + p));
      if (res(BR_CYCLES + p) > kcyc_max) kcyc_max = res(BR_CYCLES + p);
    end
    $display("\n BENCH %s  memlat=%0d  slowest_pe_cycles=%0d  wall_cycles=%0d  all_done=%0d",
             Label, MemLat, kcyc_max, totcyc, cycle);

    report_hit_rates();
    report_cycle_costs();

    $display("------------------------------------------------------------------");
    if (errors == 0) $display(" %s PASSED  (%0d checks)\n", Label, checks);
    else             $display(" %s FAILED  (%0d errors / %0d checks)\n",
                              Label, errors, checks);
    if (errors != 0) $fatal(1);
    $finish;
  end

  // ---------------------------------------------------------------------------
  //  Fig. 7 style reporting: read, write and average hit rate.
  //
  //  Write-through / no-allocate never installs a line on a store, so a store
  //  hits only where a load had already pulled the line in. Kernels that write
  //  a result they never read back therefore show a write hit rate near zero
  //  by construction, which is why the three series are reported separately
  //  rather than as one number.
  // ---------------------------------------------------------------------------
  function automatic void report_hit_rates();
    int unsigned rh, rm, wh, wm;
    int unsigned trh = 0, trm = 0, twh = 0, twm = 0;

    $display("\n per-PE cache statistics:");
    for (int unsigned p = 0; p < NumPes; p++) begin
      rh = p_rd_hit [p*32 +: 32];
      rm = p_rd_miss[p*32 +: 32];
      wh = p_wr_hit [p*32 +: 32];
      wm = p_wr_miss[p*32 +: 32];
      trh += rh; trm += rm; twh += wh; twm += wm;
      $display("  PE%0d  rd %0d/%0d hit  wr %0d/%0d hit", p, rh, rh+rm, wh, wh+wm);
    end

    $display("\n aggregate over %0d PEs:", NumPes);
    $display("  read  hit rate = %0.2f %%  (%0d of %0d)",
             (trh+trm) ? 100.0*real'(trh)/real'(trh+trm) : 0.0, trh, trh+trm);
    $display("  write hit rate = %0.2f %%  (%0d of %0d)",
             (twh+twm) ? 100.0*real'(twh)/real'(twh+twm) : 0.0, twh, twh+twm);
    $display("  average        = %0.2f %%  (%0d of %0d)",
             (trh+trm+twh+twm) ? 100.0*real'(trh+twh)/real'(trh+trm+twh+twm) : 0.0,
             trh+twh, trh+trm+twh+twm);
    // one machine-readable line, so a sweep can be scraped out of the logs
    $display(" BENCHSTAT %s rd_hit=%0d rd_tot=%0d wr_hit=%0d wr_tot=%0d",
             Label, trh, trh+trm, twh, twh+twm);
  endfunction

  // ---------------------------------------------------------------------------
  //  Where the cycles went.
  //
  //  The hit rate answers "how often did the cache answer locally". It does
  //  not answer "what did an access cost", and for a write-through cache with
  //  a snooping protocol those come apart badly: a store hits or misses but
  //  broadcasts an INV REQ either way, so a kernel can have an excellent hit
  //  rate and still be dominated by store cost. This is the second question.
  // ---------------------------------------------------------------------------
  function automatic void report_cycle_costs();
    int unsigned busy, snoop, s2, rdw, wrw;
    int unsigned reads, writes;
    int unsigned tb_ = 0, tsn = 0, ts2 = 0, trd = 0, twr = 0, trr = 0, tww = 0;

    $display("\n cycle accounting (per PE, cycles a core access spent in the DCU):");
    $display("  PE   busy   snoop-gnt   stage2   rd-wait   wr-wait   reads  writes");
    for (int unsigned p = 0; p < NumPes; p++) begin
      busy   = p_busy       [p*32 +: 32];
      snoop  = p_stall_snoop[p*32 +: 32];
      s2     = p_stall_s2   [p*32 +: 32];
      rdw    = p_rd_wait    [p*32 +: 32];
      wrw    = p_wr_wait    [p*32 +: 32];
      reads  = p_rd_hit[p*32 +: 32] + p_rd_miss[p*32 +: 32];
      writes = p_wr_hit[p*32 +: 32] + p_wr_miss[p*32 +: 32];
      tb_ += busy; tsn += snoop; ts2 += s2; trd += rdw; twr += wrw;
      trr += reads; tww += writes;
      $display("  %0d  %7d   %9d %8d  %8d  %8d %7d %7d",
               p, busy, snoop, s2, rdw, wrw, reads, writes);
    end

    $display("\n aggregate:");
    $display("  busy cycles        = %0d", tb_);
    $display("  snoop-grant wait   = %0d  (%0.1f %% of busy)",
             tsn, tb_ ? 100.0*real'(tsn)/real'(tb_) : 0.0);
    $display("  stage-2 wait       = %0d  (%0.1f %%)",
             ts2, tb_ ? 100.0*real'(ts2)/real'(tb_) : 0.0);
    $display("  line-fill wait     = %0d  (%0.1f %%)",
             trd, tb_ ? 100.0*real'(trd)/real'(tb_) : 0.0);
    $display("  write-grant wait   = %0d  (%0.1f %%)",
             twr, tb_ ? 100.0*real'(twr)/real'(tb_) : 0.0);
    $display("  cycles per read    = %0.2f   (%0d reads)",
             trr ? real'(tb_ - twr - tsn)/real'(trr) : 0.0, trr);
    $display("  cycles per write   = %0.2f   (%0d writes)",
             tww ? real'(twr + tsn)/real'(tww) : 0.0, tww);
    $display(" BENCHCYC %s busy=%0d snoop=%0d s2=%0d rdwait=%0d wrwait=%0d reads=%0d writes=%0d",
             Label, tb_, tsn, ts2, trd, twr, trr, tww);
  endfunction

  initial begin
    #800ms;   // the 128x128 matrix multiply is minutes of simulated time
    $display("*** %s TIMEOUT: done = %b ***", Label, done);
    $fatal(1);
  end

endmodule


// =============================================================================
//  The two architectures Section IV-B compares.
// =============================================================================
module tb_bench;
  bench_harness #(.Coherent(1'b1), .Label("tb_bench [coherent]")) h ();
endmodule

module tb_bench_nc;
  bench_harness #(.Coherent(1'b0), .Label("tb_bench_nc [non-coherent]")) h ();
endmodule

// -----------------------------------------------------------------------------
//  The same two, with a slower shared memory behind the fabric.
//
//  MemLat is the burst latency of the AXI SRAM: a read burst costs MemLat
//  cycles and then one beat per cycle. A cache only earns its keep when it is
//  hiding something, so the whole comparison moves with this number. At
//  MemLat=2 -- an on-chip BRAM answering almost immediately -- there is very
//  little to hide, which is why the streaming kernel does not gain there.
// -----------------------------------------------------------------------------
//  With the snoop filter: identical in every other respect, so the difference
//  between these and the three above is the filter and nothing else.
module tb_bench_sf;
  bench_harness #(.Coherent(1'b1), .Label("tb_bench [coherent filtered]"),
                  .SnoopFilter(1'b1)) h ();
endmodule

module tb_bench_sf_l8;
  bench_harness #(.Coherent(1'b1), .Label("tb_bench [coherent filtered]"),
                  .MemLat(8), .SnoopFilter(1'b1)) h ();
endmodule

module tb_bench_sf_l20;
  bench_harness #(.Coherent(1'b1), .Label("tb_bench [coherent filtered]"),
                  .MemLat(20), .SnoopFilter(1'b1)) h ();
endmodule

// -----------------------------------------------------------------------------
//  With directed invalidation: the filter, plus the fan-out and the barrier
//  restricted to the caches the mirror says are sharers. These differ from the
//  _sf variants above in one parameter, so a difference between them is the
//  direction and nothing else.
// -----------------------------------------------------------------------------
module tb_bench_di;
  bench_harness #(.Coherent(1'b1), .Label("tb_bench [coherent directed]"),
                  .SnoopFilter(1'b1), .DirectedInv(1'b1)) h ();
endmodule

module tb_bench_di_l8;
  bench_harness #(.Coherent(1'b1), .Label("tb_bench [coherent directed]"),
                  .MemLat(8), .SnoopFilter(1'b1), .DirectedInv(1'b1)) h ();
endmodule

module tb_bench_di_l20;
  bench_harness #(.Coherent(1'b1), .Label("tb_bench [coherent directed]"),
                  .MemLat(20), .SnoopFilter(1'b1), .DirectedInv(1'b1)) h ();
endmodule

module tb_bench_l8;
  bench_harness #(.Coherent(1'b1), .Label("tb_bench [coherent]"),        .MemLat(8)) h ();
endmodule

module tb_bench_nc_l8;
  bench_harness #(.Coherent(1'b0), .Label("tb_bench_nc [non-coherent]"), .MemLat(8)) h ();
endmodule

module tb_bench_l20;
  bench_harness #(.Coherent(1'b1), .Label("tb_bench [coherent]"),        .MemLat(20)) h ();
endmodule

module tb_bench_nc_l20;
  bench_harness #(.Coherent(1'b0), .Label("tb_bench_nc [non-coherent]"), .MemLat(20)) h ();
endmodule

// -----------------------------------------------------------------------------
//  Separating a capacity miss from a conflict miss.
//
//  The per-PE FFT working set is 8N bytes, so N=512 is the first size that
//  does not fit the paper's 2 KiB DCU -- and it is also the first size whose
//  butterfly half-span reaches the set-index period, so the two operands of a
//  butterfly alias onto one set. Both effects arrive together at N=512, and a
//  single run cannot tell them apart. These two do:
//
//    tb_bench_w4    4-way, 32 sets  = 2 KiB   capacity held, ways doubled
//    tb_bench_c8k   2-way, 256 sets = 8 KiB   ways held, capacity x4
//
//  If associativity is the cause, w4 recovers and c8k does not. If capacity
//  is the cause, the opposite. If both matter, both recover partially.
//
//  Only the coherent side needs re-running: the non-coherent baseline has no
//  cache, so its cycle count does not depend on either parameter.
// -----------------------------------------------------------------------------
module tb_bench_w4;
  bench_harness #(.Coherent(1'b1), .Label("tb_bench [coherent 4-way 2KiB]"),
                  .NumWays(4), .NumSets(32)) h ();
endmodule

module tb_bench_c8k;
  bench_harness #(.Coherent(1'b1), .Label("tb_bench [coherent 2-way 8KiB]"),
                  .NumWays(2), .NumSets(256)) h ();
endmodule

//  N=1024's per-PE working set is exactly 8 KiB, so an 8 KiB DCU is the
//  borderline case and would not show whether the curve is really flat.
//  16 KiB gives the working set room and tests flatness honestly.
module tb_bench_c16k;
  bench_harness #(.Coherent(1'b1), .Label("tb_bench [coherent 2-way 16KiB]"),
                  .NumWays(2), .NumSets(512)) h ();
endmodule
