Krishna-Gorai/riscv-cache-extension/(commit log)

2026-08-24 M0+M1: repository skeleton and the Data Cache Unit
    Reproduction of the DCU of Kamaleldin et al., SOCC 2024:
    two-stage pipeline, 2-way set associative, write-through/no-allocate,
    1-bit LRU per set, HCL/CCL/SCL decomposition, snoop invalidation and
    the INV-before-MEM-RESP corner case, plus read/write hit-miss counters.
    tb_dcu passes 2549 checks including a 3000-operation randomised stress
    run against a golden memory model with concurrent invalidation traffic.
2026-08-24 M2+M3: snoopy bus and the 4-core coherent sub-system
    Snoopy bus per Fig. 4: two round-robin arbiters (INV/SC and LR), the Link
    Register with its exclusive bit, and the Invalidation Table screening READ
    REQs to realise the MRSW lock. coherent_subsystem ties NumCores DCUs to one
    bus; the whole thing is parameterised in core count, associativity, sets and
    line width.
    Three protocol bugs found and fixed by the new testbench:
    - the DCU array read port was stolen by stage 1 while stage 2 stalled, so
    hit decisions after a stall evaluated a foreign set
    - the MRSW lock was released on INV grant rather than on write completion,
    letting a remote read cache a pre-write value that nothing wo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
    [coherent_subsystem.sv, dcu.sv, invalidation_table.sv, link_register.sv, rr_arbiter.sv, shared_mem_model.sv, snoopy_bus.sv, tb_coherent_subsystem.sv]
2026-08-24 M4: Processing Element with an unmodified CV32E40P
    Adds cv32e40p as a pinned submodule (6033d2b) and builds one PE around it:
    ITCM with separate instruction and data ports, an Instruction-Bridge and a
    Data-Bridge sharing a common request router, and the bare-metal software
    flow (crt0, linker script, kernel build script, bin2hex).
    The router drains outstanding transactions before switching target region,
    because the OBI-style core port returns responses strictly in order and the
    targets have different latencies. Requests that decode to no region are
    absorbed by a void responder so a stray access cannot lock the core up.
    tb_pe boots a compiled C kernel from the ITCM, reaches the coherent sha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
2026-08-25 M5b: an AXI4 crossbar in place of the direct arbiters
    Table I of the paper lists the AXI crossbar as its own resource line, so M5's
    round-robin arbiters in front of the shared memories are replaced by a real
    fabric:
    axi/axi_xbar.sv the crossbar
    axi/axi_sram.sv AXI4 slave wrapping a memory array
    axi/axi_ctrl.sv control region + hardware barrier, as a slave
    axi/axi_master_simple.sv single-beat port -> AXI4
    axi/axi_master_dcu.sv cache memory port -> AXI4
    AXI4 rather than AXI4-Lite is the whole point: a DCU line fill is one INCR
    burst of LineBytes/4 beats, so a miss pays for one arbitration and one address
    phase instead of four, and write-through is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
    [axi_ctrl.sv, axi_master_dcu.sv, axi_master_simple.sv, axi_sram.sv, axi_xbar.sv, data_bridge.sv, pe_top.sv, soc_top.sv]
2026-08-25 Fix the simulation stall: always_comb -> always @(*)
    The SoC builds stopped advancing simulation time -- the coherent one since M5,
    both of them since the crossbar landed. Root cause found, and it was never a
    design defect.
    Icarus Verilog derives an always_comb sensitivity list from every signal the
    block references, including ones it only writes. A block that clears a vector
    and then conditionally sets part of it therefore reschedules itself on its own
    writes and never settles, so time freezes. always @(*) takes its sensitivity
    from reads alone and does not. The two are identical for synthesis; the cost is
    weaker compile-time checking, which is worth paying to keep the repository
    runnable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
    [axi_xbar.sv, bridge_router.sv, cache_ram.sv, coherent_subsystem.sv, data_bridge.sv, dcu.sv, dcu_hcl.sv, instr_bridge.sv]
2026-08-28 Fix the tb_axi decode-error handshake polling, and repoint xsim to C:
    tb_axi passed under Icarus but failed under xsim with three errors on the
    A7 decode-error path. The RTL was correct in both: a read-only monitor on
    master 3 showed axi_xbar emitting the AXI-legal sequence for a write to an
    unmapped address -- AW handshake, W beat with WLAST, then B with DECERR.
    The testbench was at fault, twice:
    - It polled "m_awvalid[3] && m_awready[3]" at @(posedge clk) followed by
    #1. The crossbar consumes the request on the edge and drops READY at
    that same edge, so the handshake window is already gone one delta
    later and the poll spins until its guard expires. Whether it works at
    a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
    [tb_axi.sv]
2026-08-28 Reproduce Fig. 6: size the kernels to the paper and accumulate in memory
    The M6 speedups missed Fig. 6 badly -- matmul 2.51x against the paper's
    1.67x, conv2d 1.27x, and memcpy actually slower with the cache. The
    suspicion was that the non-coherent baseline was too harsh. It is not, and
    nothing in the RTL is touched here.
    Section III-A of the paper settles the baseline question: "All shared
    memories are implemented as dual-ported BRAM blocks where two memory
    requests can be handled simultaneously across the AXI crossbar." Both
    architectures use the same BRAM behind the same crossbar and differ only
    by the DCU, which is what dcu_bypass and axi_sram already model, and BRAM
    at their 60 MHz is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
    [bench_conv2d.c, bench_fft.c, bench_matmul.c]
2026-08-28 Build every kernel at the sizes the paper actually evaluates
    Fig. 5 sweeps memory copy over 4/8/16/32 KiB. Figs. 6 and 7 sweep matrix
    multiply and 2-D convolution over 32x32, 64x64 and 128x128, and the FFT
    over 128, 256, 512 and 1024 points. Fourteen configurations, and until now
    the tree built one of each kernel at whatever size it was first written at.
    Size and golden checksum are both compiled in, so each configuration is a
    separate image. build.sh takes KCFLAGS and OUT_SUFFIX; build_bench.sh
    drives it from scripts/bench_golden.py so the sizes and the goldens are
    never written down twice and cannot drift apart.
    Three things had to change to survive the larger sizes:
    - The results blo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
    [bench_conv2d.c, bench_fft.c, bench_matmul.c, bench_memcpy.c, tb_bench.sv]
2026-08-28 Give each PE its own FFT, the way Fig. 6 measures it
    Fig. 6 labels its x-axis "FFT Input Size per Sample". That "per Sample" is
    the decomposition: each PE owns a sample buffer and transforms it end to
    end, rather than four PEs splitting one transform between them.
    The old kernel split a single transform, which meant a barrier at every one
    of the log2(N) stage boundaries and a round of cross-PE invalidation each
    time a stage rewrote the operands the next stage reads. Both of those grow
    with N, so the measured reduction fell from 13.9 % at N=128 to 3.5 % at
    N=1024 while the paper reports a roughly flat ~23 %. It was measuring the
    cost of the decomposition, not the cache.
    With the transform m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
2026-08-28 Show that the FFT cliff is cache capacity, not associativity
    Once each PE transforms its own buffer, the per-PE working set is 8N bytes
    against a 2 KiB DCU. N=256 is the last size that fits, and the measured
    reduction falls off exactly there: 24.8 % at N=256, 0.4 % at N=512, and
    -4.3 % at N=1024, where the cache is a net loss.
    Two things arrive together at N=512, and a single run cannot separate them.
    The working set stops fitting, and the butterfly half-span reaches the
    set-index period so the two operands of a butterfly alias onto one set --
    the sets repeat every 1024 B, IM sits 2048 B after RE, and once half >= 256
    re[ia] and re[ib] are congruent too, leaving four live addresses competin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
2026-08-29 Read the routed reports as the paper's Table I, and fix the SAIF path
    Table I is a per-module breakdown, not a device total: the PE and its parts,
    the cache extension and its parts, and the interconnect each get a line.
    fpga_report.py answers what the extension cost; scripts/table1.py answers
    where the area goes, which is the question the table actually asks. It
    rebuilds full instance paths from the indentation in post_route_util_hier.rpt,
    because the report prints bare names and u_core appears four times. --latex
    emits the tabular directly.
    What the breakdown shows that the flat delta did not: the cache extension is
    20% of the SoC's LUTs against the four cores' 64%, so it is not the area
    s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
2026-08-31 Add a project generator, for the jobs a checkpoint cannot do
    run_impl.tcl stays the flow of record: non-project mode, no .xpr, no project
    state to drift, and every number in fpga/reports_* came out of it. But a batch
    flow is a poor place to edit RTL and re-run, so this builds a managed project
    for the GUI instead.
    Sources are referenced, not copied, so the project and the batch flow always
    build the same text and an edit made in the GUI is an edit to the repo. Both
    read the same file list, which means a file added to one has to be added to
    the other; that duplication is the price of having both, and is why the batch
    flow remains authoritative.
    vivado -mode batch -source fpga/create_pro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
2026-08-31 Run the GUI project, and find out the batch build was lucky
    fpga/run_project.tcl drives the managed project's synth_1 and impl_1, i.e. the
    runs the GUI's buttons launch. Reports go to fpga/reports_prj_<variant>/ in the
    same shape run_impl.tcl writes, so fpga_report.py and table1.py read them too,
    and nothing can be mistaken for fpga/reports_<variant>/, which stays the flow
    of record.
    The run completed as "route_design Complete, Failed Timing!" and the reason is
    worth more than the run:
    build WNS WHS removal failures
    coherent, batch +0.319 +0.012 0
    coherent, project +0.091 -0.030 1719
    baseline, batch +0.228 -0.111 1899
    Setup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
2026-08-31 Replicate the reset, and trade a 30 ps win for a 1.5 ns loss
    MAX_FANOUT = 200 on rst_n_q in fpga_top.sv, so the tool replicates the one
    register that drives every asynchronous reset in the SoC -- roughly fifteen
    thousand CLR pins -- and places each copy near the flops it clears.
    It did what it was asked to. The netlist carries rst_n_q_reg_rep__* replicas
    and the removal failures are gone from both variants:
    removal WHS removal failures
    baseline before -0.111 1899
    baseline after +0.022 0
    coherent before +0.167 0
    coherent after +0.077 0
    The reset is no longer placement luck. But the replicas are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
    [fpga_top.sv]
2026-09-01 Give the design a program, and prove the routed netlist runs it
    The implemented design had no way to obtain a program. Memory initialisation
    sat inside `ifndef SYNTHESIS, and every testbench loaded one by reaching into
    the hierarchy and writing the array directly -- which a netlist has no
    hierarchy to permit. The routed design would have booted into empty memory and
    fetched zeros. The reports were still valid, since resource and timing numbers
    do not depend on memory contents, but the design was not deployable.
    Vivado honours $readmemh in an initial block and turns it into the block RAM's
    INIT strings, so the fix is to let that initialisation survive synthesis and
    thread a path to it:
    -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
    [axi_sram.sv, fpga_top.sv, itcm.sv, soc_top.sv, tb_fpga_top.sv]
2026-09-01 Make the post-implementation waveform openable
    Two things stood between a passing netlist run and a waveform anyone could
    look at.
    run_fpga_sim.ps1's -Wave logged "-recursive *" from the testbench down, which
    on a 22 MB netlist over twenty-five thousand cycles means tens of gigabytes and
    hours of writing, for signals whose synthesis-mangled names are mostly
    unreadable anyway. It now logs the testbench scope and fpga_top's own signals:
    the board pins, the clock and reset sequence, and the done and exit-code probes
    taken off the routed flip-flops. That is what the run is about, and it comes to
    15 MB.
    fpga/open_wave.tcl then opens it. open_wave_database on its own loads the
    database and shows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
2026-09-01 Measure whether the FFT cliff is capacity or conflict, and record it
    The claim that the FFT cliff is a capacity effect existed only as a conclusion.
    The testbenches that would show it were in the tree, but no data was, so
    nothing in the repository could be pointed at. This runs them and keeps the
    numbers.
    At N=512 the per-PE working set first exceeds the paper's 2 KiB DCU, and the
    butterfly half-span first reaches the set-index period, so capacity pressure
    and operand aliasing arrive together. Holding one variable at a time separates
    them.
    Read hit rate, FFT, coherent:
    N set 2-way 2K 4-way 2K 2-way 8K 2-way 16K
    128 1K 96.8 96.8 96.8 96.8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
    [capacity.csv]
2026-09-01 Write up what we have, in IEEE two-column form
    An interim report rather than a submission draft: it states the results
    obtained so far, and marks in red the one section whose evidence is still being
    collected, so no reader can mistake a provisional number for a settled one.
    The argument it makes is not "we reproduced this". A reproduction on its own is
    not a contribution. What the report claims is what we found while reproducing:
    - The flat FFT curve of the original does not follow from the 2 KiB cache the
    original states. Four configurations, bit-identical at the two sizes whose
    working set fits, separate capacity from conflict: associativity returns 4.8
    points at N=512 and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
2026-09-01 Measure what the extension is worth, and find it can be worth less than nothing
    The claim that the extension's benefit depends on memory latency rested on
    remembered numbers, as the capacity claim had. This measures it: both builds,
    four kernels, three memory latencies.
    kernel MemLat 2 MemLat 8 MemLat 20
    memcpy 16 KiB 0.975 1.509 2.285
    FFT N=256 1.329 2.267 4.425
    matmul 64x64 1.638 3.067 4.570
    conv2d 64x64 1.852 4.133 7.941
    At a memory latency of two cycles the extension makes memcpy SLOWER: 21010
    cycles against the baseline's 20493. The same kernel unchanged reaches 2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
    [memlat.csv]
2026-09-01 Make the README describe the project that exists
    It had drifted badly. It reported tb_soc as "not yet run" when it passes 273
    checks, marked M6 through M9 as outstanding when all four are finished, pointed
    three times at a docs/ directory that does not exist, and led with a 2.6x
    speedup measured against a core-shaped stub rather than the real core.
    That last one is the reason this matters beyond tidiness. Anyone arriving from
    the paper would have read 2.6x as the result. The real-core figure is 1.79x,
    and the honest version is that no single number is the result at all: the
    speedup ranges from 0.975x to 7.941x across kernels and memory latencies, and
    which end you land on depends on the pla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
2026-09-01 Put the measured data in the tables, not just what we concluded from it
    Both result tables reported derived figures only -- hit rates and speedup
    ratios -- while the cycle counts they came from lived in the CSVs. A reader
    could not check the arithmetic, and a ratio with no numerator is a claim rather
    than a measurement.
    Table I now carries all sixteen capacity runs in two panels, read hit rate over
    execution cycles, so the 24.5% and 27.6% figures quoted in the text can be
    derived from the table that sits beside them. It also shows something the hit
    rates alone do not: 16 KiB and 8 KiB agree to the cycle, not merely to the
    tenth of a percent.
    Table II becomes a full-width table carrying all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
2026-09-01 Plot the results in the reference's visual language
    Kamaleldin et al.'s figures are Excel-style: a closed box frame, a light grid,
    square and diamond markers, a bordered legend inside the plot area, execution
    time in thousands of cycles, and a palette in which green is the cached
    configuration and red the uncached one. scripts/plot_results.py matches that
    deliberately. A reader holding our figures against theirs should be comparing
    data, not decoding two visual languages.
    Our capacity figure has four configurations where theirs has two, so the
    two-colour semantic is extended rather than abandoned: the paper's own
    configuration is red because it is the one that fails, and the configuration
    t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
2026-09-01 Draw the results as grouped bars, so no series hides behind another
    As lines, several series overlapped, and in one place that was not merely untidy
    but misleading. The 8 KiB and 16 KiB capacity curves are identical numbers at
    every point -- which is the saturation the whole capacity claim rests on -- but
    drawn as lines they superimposed exactly and read as a missing series rather
    than as a result. The two 2 KiB curves nearly coincided in the execution-time
    panel for the same reason: they differ by under 4%.
    Grouped bars fix that by construction, and are also closer to the reference,
    whose Fig. 6 is a grouped bar chart. Equal values now stand side by side at
    equal height and state the point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
2026-09-03 Size the opportunity before building the mechanism
    Design note for the reuse-aware bypass, and the measurement that decides
    whether it is worth building.
    The idea: a DCU that switches per PE at runtime between cached mode and a
    streaming mode, and pays the coherence toll only when it will earn it.
    Streaming mode changes three things and only for ordinary reads -- no snoopy-bus
    READ REQ, no allocation, word-granularity reads. Writes, load-reserved,
    store-conditional and remote invalidation handling are untouched.
    It is correct because the policy is write-through, so memory always holds the
    current value. A streaming read returns that value; it installs nothing, so it
    cannot create a stale c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
    [snoop_cost.csv]
2026-09-03 Redirect the design: arbitrate on misses, not on every read
    The streaming mode this note first proposed was wrong, and the measurements
    said so before any of it was written.
    The non-coherent baseline already is word-granularity streaming with no snoop,
    so it bounds what such a mode could return: on memcpy it beats the cache at
    MemLat 2 by 2.5% and then loses by better than two to one at 8 and 20, because
    a line fill amortises one memory latency across four words. Built that way,
    streaming mode would have been the wrong design nearly everywhere.
    Looking instead at where the time goes found something better. snp_req_o is
    asserted for every core read and stage 1 stalls on the grant, because t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
2026-09-03 Build the speculative bypass, measure it, and reject it
    Implemented behind a SpecHit parameter, run on conv2d at both memory latencies,
    and reverted. Both halves of the premise were false.
    It does not help. 168,937 cycles against the baseline's 168,177 at MemLat 2,
    and 203,353 against 202,825 at MemLat 20 -- slower at both, with more snoop
    stall rather than less.
    snoopy_bus.sv explains why, and had said so all along: "Plain READ REQs are not
    arbitrated against each other -- multiple readers may proceed in the same
    cycle." Reads never queued for a grant. There was no arbitration cost to
    remove, so removing it saved nothing and the extra stage-2 state cost a little.
    It is also not correct,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
2026-09-03 Find that essentially all the coherence traffic is unnecessary
    Two measurements, the second prompted by the first coming back empty.
    Reads are never blocked. The MRSW screening that the rejected speculative
    bypass tried to remove does not fire once across any of the four kernels, so
    whatever the snoop-stall counter has been reporting, it is not readers waiting
    on writers. By elimination it is writes: those ARE arbitrated one per cycle,
    and the grant is withheld until every other DCU can accept the broadcast.
    So the question became whether those broadcasts are worth sending. Each DCU now
    counts how many arrived and how many found a line to clear:
    workload broadcasts useful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
    [invalidation_use.csv]
2026-09-03 Measure what a snoop filter is worth, before building one
    An oracle behind ORACLE_NOBCAST: suppress every invalidation broadcast and the
    handshake that waits for the other DCUs to accept it. Arbitration and the
    write-busy lock are left alone, because that lock still has to stop a remote
    read fetching a pre-write value whoever is caching what. It is a measurement
    instrument, documented as never to be built, and it is only sound because
    results/invalidation_use.csv says not one of a million broadcasts was useful.
    kernel baseline oracle speedup snoop stall
    matmul 64x64 1,337,850 1,094,750 1.222x 483,281 -> 1,127
    memcpy 16 KiB 21,010 18,708 1.123x 7,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
    [oracle_ceiling.csv]
2026-09-03 Build the snoop filter, and hit the oracle exactly
    An exact mirror of the DCUs' tag and valid arrays, held in the bus and updated
    by the same two events that change the caches themselves: a refill installs a
    tag into a way, an invalidation clears one. When the mirror says no other cache
    holds the line, the broadcast is suppressed. Exactness is structural rather than
    argued -- the mirror is written from the same signals, on the same edge, by the
    same conditions -- which is a far easier thing to defend than either of the two
    mechanisms this replaced.
    A hashed filter was rejected deliberately: it may only over-approximate, so
    insert-only is safe but saturates on matmul's footprint, and removin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
    [snoop_filter.csv]
2026-09-03 Find that the snoop filter gives its cycles back in frequency
    Both variants built at 75 MHz through the same flow, so the difference between
    the reports is the filter and nothing else.
    metric filtered coherent delta
    LUT 31,204 26,762 +4,442
    FF 26,954 15,154 +11,800
    BRAM tiles 124 124 0
    WNS setup -0.423 +1.327 -1.750
    Fmax 72.70 MHz 83.29 MHz -10.6
    met no yes
    The filtered design does not close at 75 MHz: 334 failing endpoints.
    The part that matters is not the failure but the arithmetic. The filter buys
    1.122x fewer cycles and costs 0.873x the frequ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
    [fpga_filter_cost.csv]
2026-09-05 Fix the mirror's area, and learn the timing cost was never its size
    The mirror was 11,776 flip-flops and no memory at all: distributed RAM count
    was zero. Two reasons, both visible once looked for. The array sat under an
    asynchronous reset, which a RAM has no equivalent for -- the same fault that
    cost this project a 2 Mbit LUTRAM in axi_sram -- and the query read four cores
    and two ways combinationally, which no single RAM serves.
    Restructured the way the DCU already divides its own arrays: tags into eight
    per-(core, way) memories with one write and one read port each, held outside
    any reset because a tag is only compared when its valid bit says it means
    something; valid bits left in flip-f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
    [mirror_structure.csv]
2026-09-05 Draft the DATE title and abstract
    Registration closes 13 September and needs only a title, an abstract and
    co-authors, so it is worth having ready well before the RTL is.
    The title changed with the mechanism. "Knowing When Not to Cache" described the
    reuse-aware bypass, which the measurements rejected; the paper is now about
    finding that a million invalidation broadcasts invalidate nothing, and removing
    The abstract leads with the measurement rather than the mechanism, because the
    measurement is the surprising part and the mechanism follows from it. It gives
    the area cost, the coherence argument, the geometric mean and the streaming
    kernel crossing back above an uncached baseline.
    I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
2026-09-05 Title the paper for what it contributes
    "An Exact Snoop Filter for Seamless Cache Coherence in FPGA-Based Multi-Core
    RISC-V".
    Exact is the technical differentiator and earns its place: the filter mirrors
    the caches' tag arrays structurally rather than approximating them with a hash,
    which is what makes the correctness argument a paragraph instead of a section,
    and it is the first thing a reviewer will check. The title also reads as an
    architecture contribution rather than a measurement study, which is right --
    the reproduction motivates the work, it is not the claim.
    Set aside a measurement-first title and a colon hook, both of which foreground
    the finding at the cost of the mechanism.
2026-09-05 Close both variants at 60 MHz, and refuse the flattering Fmax
    Both built through the same flow at the frequency the original design runs at.
    metric filtered reference delta
    LUT 27,776 26,767 +1,009
    FF 15,673 15,154 +519
    BRAM 124 124 0
    DSP 20 20 0
    WNS +4.307 +2.597
    failing 0 0
    met yes yes
    The filter costs 1,009 LUTs and 519 flip-flops, under 4% of the design, and at
    a fixed 60 MHz that buys the full 1.122x geometric mean and 1.222x on matmul.
    That is the result the paper reports.
    One number is deliberately l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
    [fpga_60mhz.csv]
2026-09-05 Write the DATE paper
    Four pages, IEEEtran, builds clean: no errors, no overfull boxes, no undefined
    references. Anonymous by default with the author block and the repository URL
    behind one toggle, because DATE's blind-review policy for the research track
    still needs confirming and the URL de-anonymises the work instantly.
    Structured so the measurement leads and the mechanism follows from it, which is
    the honest order: Section III establishes that 6 to 33% of runtime goes to the
    coherence bus, that it is not readers waiting on writers -- reads are never
    withheld, not once -- and that by elimination it is invalidations, of which
    1,048,821 are sent and none are useful. Section IV then has some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
2026-09-05 Position the filter against the snoop-filtering literature
    Filtering snoops is not new, so the section says plainly what is different here
    rather than claiming the concept.
    JETTY puts a small approximate structure between the bus and each processor's
    L2 so that a snoop which would miss locally never costs a tag lookup: its target
    is energy, its position is the receiving side, and it filters most useless
    snoops rather than all. Coarse-grain coherence tracking and RegionScout raise
    the granularity instead, tracking sharing over regions so an unshared region
    needs no broadcast, trading precision for a far smaller structure.
    Our setting inverts which cost matters. On a snooping bus in a soft m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
2026-09-05 Draw the architecture, with the contribution visible as the contribution
    paper/architecture.drawio, editable in draw.io or diagrams.net. 33 boxes, 20
    edges, valid XML.
    Laid out the way the system is: four unmodified CV32E40P processing elements
    over their private DCUs, the snoopy bus beneath them, then the AXI4 crossbar and
    the shared memories. That much is the design being reproduced, and it is drawn
    plainly so a reader who knows the original recognises it.
    What the diagram has to earn is showing which part is new, and it does that two
    ways rather than one. The snoop filter is the only block with a heavy border and
    a grey fill, and it carries what it costs -- tags in LUTRAM, valid bits in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
2026-09-05 Put the architecture figure in the paper
    The draw.io CLI would not export from a non-interactive shell -- the desktop app
    is installed and refused every invocation -- so the figure the paper includes is
    TikZ instead, built by pdflatex like the rest of the document. That is the better
    artifact anyway: vector at any scale, type matching the body text, and it
    rebuilds with the paper rather than depending on an application being present.
    paper/architecture.drawio stays as an editable copy for slides, and the two now
    have to be kept in step by hand, which is the cost of having both.
    Laid out by absolute coordinates rather than relative chains: the diagram has
    three horizontal buses and several l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
2026-09-05 Connect the memory path to something
    The write-through line was drawn from x=-18, which is just clear of DCU0's left
    edge at -16, so it began in empty space and ended at the crossbar's top edge
    without touching either box. It read as a line passing behind the diagram rather
    than as a connection.
    It now leaves DCU0's left face, routes down outside the snoopy bus, and enters
    the crossbar's left face, with arrowheads landing on both.
    The label gained "one AXI master per DCU" while fixing it. One line standing for
    four was already the intent, but drawn from DCU0 alone and unlabelled it implied
    the other three reach memory through the snoopy bus, which is not how the design
    works: the coherence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
2026-09-08 Replace the cost table with the full resource hierarchy
    Table IV gave two columns and a delta. It answered what the filter costs and
    nothing about where it sits, so a reader could not tell whether 1,009 LUTs was
    a large addition or a rounding error against the design around it.
    It now carries every module: the four processing elements and their cores,
    bridges and masters; the cache extension broken down to the DCU's controller,
    tag and data arrays; the snoopy bus with its arbiter, Invalidation Table and the
    filter itself; then the crossbar, the memories and the control region. A LUTRAM
    column is added, without which the filter's 414 LUTs read as ordinary logic when
    half of them are distribu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
2026-09-08 Cover fills in flight in the snoop filter, and add directed invalidation
    The filter mirrored the DCUs' committed tag arrays and suppressed a broadcast
    when no other cache held the line. That is exact about the wrong property. A DCU
    between issuing its memory read and refilling the victim way holds nothing for
    the line it is fetching, so it is absent from the mirror -- and it is precisely
    the cache that has to receive the invalidation, because receiving one in that
    window is what cancels its refill (dcu.sv "special case 2"). Suppress it and the
    cache installs a line that was invalidated while in flight.
    The property is residency OR imminent residency. dcu.sv now exports its refill
    window and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
    [coherent_subsystem.sv, dcu.sv, fpga_top.sv, snoopy_bus.sv, soc_top.sv, tb_bench.sv, tb_coherent_subsystem.sv]
2026-09-08 Sweep the coherence stress over many interleavings
    The fill-in-flight race appeared once in 211 granted invalidations on the
    default seed. A single run is exactly the sample size that makes a race of that
    frequency look like a fluke, so any claim about it has to be made across many
    interleavings.
    Ten seeds per mode: suppression 20 of 2,241 granted invalidations would have
    been wrong with a committed-tag mirror, hitting in 10 of 10 runs; directed 29 of
    2,222, in 9 of 10. All twenty runs pass with the fill term in place.
    The script rewrites the `define STRESS_SEED line rather than passing a define,
    and restores it in a finally block. xvlog splits -d NAME=VALUE at the "=" and
    then treats the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
    [seed_sweep.csv]
2026-09-08 Repair the filter's correctness argument, and record what did not work
    Section IV claimed "when the mirror reports that no other cache holds the line,
    no other cache holds it, so a broadcast would clear nothing anywhere". That was
    the bug: a cache with a refill in flight holds nothing and still has to be told.
    The section now asks whether another cache has to hear the invalidation rather
    than whether one holds the line, and a new subsection gives the fill-in-flight
    window, why the two halves of the answer abut exactly, and the measurement that
    20 of 2,241 granted invalidations across ten interleavings turn on it.
    Directed invalidation goes into "What Did Not Work" with the stencil result. I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
2026-09-08 Record the FPGA cost measurement as partial: synthesis only
    The filtered 60 MHz run completed synthesis and was killed in place-and-route
    when the host ran out of memory, so there is no post-route number for the fixed
    RTL. Synthesis puts the fill-in-flight term at +77 LUTs and -3 flip-flops
    against the filter's published 1,009 / 519.
    That is not a substitute for the post-route figure the paper quotes -- the
    published flow went 28,046 LUTs at synthesis to 27,776 after routing, so
    inferring one from the other would be a guess, and whether the design still
    meets 60 MHz cannot be inferred at all. Until a full run completes, the cycle
    results are current and the FPGA cost figures predate the fix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
2026-09-08 Re-measure FPGA cost against the fixed RTL, both variants in one batch
    The fill-in-flight term added logic to the snoopy bus, so the published cost
    figures needed re-measuring. Both variants were implemented at 60 MHz on the
    same source tree with one parameter changed:
    LUTs 26,781 -> 27,845 filter costs +1,064 (published +1,009)
    FFs 15,154 -> 15,670 filter costs +516 (published +519)
    WNS +1.265 +1.199 filter costs 66 ps
    Failing endpoints 0 and 0; both meet 60 MHz.
    So the correctness fix costs +55 LUTs and no measurable slack.
    The reference had to be re-run rather than reused, and that turned out to matter
    more than the number. Comparing the new filtered bu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
    [fpga_60mhz.csv]
2026-09-10 Sweep execution time against problem size, on the reference's own axes
    Everything measured here so far swept memory latency at one size per kernel.
    Kamaleldin et al.'s execution-time figure sweeps PROBLEM SIZE at a fixed clock,
    so none of our data could be plotted against it. This adds the missing 16 runs
    and the two figures they support.
    Three configurations at each of nine (kernel, size) points: non-coherent, which
    is their "Cores w/o Data Cache"; coherent, their "Cores w/ Data Cache"; and
    coherent plus the snoop filter, which they have no counterpart to.
    matmul 32x32 277,621 -> 171,142 -> 140,223 38.4% -> 49.5%
    matmul 64x64 2,191,981 -> 1,337,850 -> 1,094,750 39.0% ->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
    [fig6.csv]
2026-09-10 Add the execution-time figure to both papers, and move Related Work forward
    Both papers gain the size sweep on the reference's own axes, so a reader can
    hold the two figures side by side. The reproduction paper gets the two-bar
    version, which is the reference's comparison and nothing else. The DATE paper
    gets the three-bar version, where the third bar is the filter.
    The explanation is the part worth having. One model accounts for all three
    kernels: what has to stay resident is not the data set but the reuse footprint,
    the bytes a core revisits before moving on. That is one row of B for matrix
    multiplication (4N bytes, 512 B at N=128) and the three-row sliding window for
    convolution (12N byt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
2026-09-10 WIP: add the execution-time data table; date2027 is 7 pages pending a decision
    Adds paper/tab_exec.tex, the 27 cycle counts behind the execution-time figure,
    and shrinks the figure to 1.95in to help it fit.
    DO NOT SUBMIT THIS STATE. date2027 is currently SEVEN pages, about eight lines
    over DATE's six-page limit. The overflow has not moved across five separate
    prose trims, because the last reference is a fixed block that either fits on
    page 6 or does not; shaving sentences no longer reaches it.
    Four floats have already been removed to make room for one figure and one
    table -- tab:stall, fig_result, tab:speedup and now tab:invuse -- each commented
    in the source with what replaced it. That is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
2026-09-10 Sweep memory-copy latency against transfer size at three memory latencies
    Reproduces the axes of the reference's memory-copy figure, which sweeps transfer
    size at a fixed clock and reports latency "approximately reduced by 50 %" with
    the data cache.
    Whether that reproduces turns out to depend entirely on how slow the shared
    memory is, which the reference never states. So this sweeps 4 to 32 KiB at
    MemLat 2, 8 and 20 rather than picking the one latency that agrees:
    MemLat 2: cache -6.6 to -2.5 % filter +8.2 to +9.0 %
    MemLat 8: cache +33.7 to +37.5 % filter +50.5 to +55.5 %
    MemLat 20: cache +56.2 to +57.9 % filter +71.3 to +71.6 %
    At a memory latency of two -- a block RAM answe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
    [fig5.csv]
2026-09-11 Build the filtered variant as a GUI project and verify the routed netlist
    The three project-flow scripts only understood 'coherent' and 'baseline', and
    create_project.tcl passed only Coherent as a generic. None of them could build
    the design the paper is actually about. They now take 'filtered' and 'directed'
    and pass SnoopFilter and DirectedInv, matching run_impl.tcl, with a comment
    saying that where the two disagree about what a variant means, run_impl.tcl is
    the one to trust: every number in the paper came out of it.
    Post-implementation functional simulation of the filtered design PASSES, five
    checks: all four PEs reach done before the timeout and each reports exit_code
    == 1. The timeout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
2026-09-11 Give the GUI project a simulation fileset, with the define on the right step
    Two real defects, both mine, found while chasing a "failed due to previous
    errors" from the GUI's Run Simulation button.
    sim_1 was EMPTY. create_project.tcl added design sources and constraints and
    never a testbench, so the GUI had no top to elaborate. It now adds
    tb_fpga_top.sv, sets the top, enables glbl (a gate-level design stays in reset
    without it, since glbl is what drives GSR) and sets runtime to all (the GUI
    otherwise stops at 1000 ns, long before four PEs have booted).
    The NETLIST define was on the wrong step. It was set through
    xsim.elaborate.xelab.more_options, but `ifdef is a preprocessor directive and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
2026-09-11 Make the snoop filter's mechanism findable in a waveform
    The netlist waveform shows the outcome -- done goes high, exit codes read 1 --
    and says nothing about how the filter decides. These three changes make the
    decision itself visible.
    scripts/open_wave_filter.tcl opens the coherence waveform with the signals
    grouped in the order the decision is actually made, so the window reads top to
    bottom as one invalidation's journey: the request, the arbiter's pick, the
    mirror's answer, the fill-in-flight term, their union, the broadcast decision,
    the handshake, and what the DCUs finally see. tb_coherent_subsystem is the run
    worth looking at because it shares on purpose -- about half its invalidatio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
2026-09-12 Cache-block the FFT so its working set stays inside the DCU
    The plain FFT's benefit collapses above N=256 because a radix-2 pass
    revisits all 8N bytes of the signal; this reorders the stages so that
    the early ones run block by block and the late ones column by column,
    with every butterfly, operand and per-stage order unchanged. Output is
    bit-identical and the fftb rows share the plain kernel's golden as the
    proof. At N=1024 the extension goes from -4.3% to +10.4%, and with the
    filter to +18.2%.
    Fig. 6 gains a fourth panel (three-series version only), tab_exec the
    three fftb rows, and both wide figures are 0.2 in shorter.
    [fig6.csv]
2026-09-12 Derive the filter's benefit from the grant condition, and check it
    New Section IV-D: per write, the original protocol charges the sender's
    wait for a grant conditioned on every other DCU being ready, plus one
    displaced pipeline slot in each receiver. Readiness is lost while a DCU
    holds an invalidation in stage 1, which drains only when stage 2 is
    free -- and stage 2 is held for the whole memory latency of any miss or
    write-through in flight, so a store on one core waits on a load miss on
    another regardless of sharing. With an empty sharer set the filter
    zeroes both terms, leaving arbitration collisions: exactly the oracle.
    The model is checked against the counters rather than fitted: the
    se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
2026-09-12 Draw the snoop filter's internals: mirror, comparators, valid gating, sharer OR
    Standalone TikZ figure of the decision path from the DCU update ports through the tag mirror, per-way comparators ANDed with the valid bits, the per-core OR, the mask, the union with fills in flight, and the final AND with the arbiter's request. Not yet placed in date2027.tex, which has no room for it.
2026-09-12 Rewrite the paper in the register of the reference
    Every abbreviation and symbol is now defined at first use (PE, DCU, ITCM,
    HCL, CCL, SCL, READ/WRITE/INV REQ, MEM READ/WRITE REQ, MEM RESP, MRSW,
    RR, LR, SC, memory latency, busy and snoop-stall cycles, useful INV REQ,
    sharer set, oracle, and the model's P, a(w), g(w), arb(t), r_j(t), rho_j),
    section headings are descriptive rather than slogans, and each result is
    followed by its reason in plain declarative prose. The cost model is
    folded into the main file. Two figures are slightly shorter and the
    tables one size smaller so that the body still ends on page 6 with the
    references alone on page 7.
2026-09-12 Redraw Fig. 1 in the terminology of Section III, with no crossing lines
    Every block and signal the text names now appears in the figure: the PE
    with its CV32E40P core, Instruction-Bridge, Data-Bridge, ITCM and DCU
    (Status-/Tag-/Data-RAM, LRU, stage 1 / stage 2 with HCL, CCL, SCL);
    READ REQ, WRITE REQ and RESP between core and DCU; INV REQ, READ REQ,
    grant and INV REQ broadcast between DCU and snoopy bus; the mirror update
    and fill-in-flight port to the filter; MEM READ REQ, MEM WRITE REQ and
    MEM RESP to the AXI4 crossbar; the INV REQ arbiter, Invalidation Table,
    LR REQ arbiter, Link Register and snoop filter with its sharer set S(w).
    The snoopy bus is drawn as a bus with tapped junctions so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
2026-09-13 Redraw the snoop filter's internals in the paper's terminology
    Every block and signal now has a definition in Section V: the update port
    (the DCU's Status-RAM and Tag-RAM write signals), the fill-in-flight signal
    with its address, the INV REQ selected by the arbiter with its issuing PE i
    and the address of w, the Tag-RAM mirror in LUTRAM read at the set index,
    the valid bit in flip-flops, the compare "stored tag = tag of w and valid",
    the OR over the two ways, the fill compare, the exclusion of PE i, the
    sharer set S(w), and the S(w) = empty decision feeding grant condition (1).
    Section V-A gains the sentence that describes this lookup.
    Crossing-free by construction: the "address of w" is o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
2026-09-13 Draw the filter's decision with gate symbols
    The tag comparison is a comparator block, its result is ANDed with the valid bit, the two ways are ORed, the fill term is ORed in, and a four-input NOR over the sharer set yields S(w) = empty. Gate inputs are fed by orthogonal jogs at different heights with the left source on the left input, so the drawing stays free of crossings. Section V-A now says ANDed rather than qualified, to match.
2026-09-13 Put the snoop filter's decision path into the paper as Fig. 2
    A single-column variant of fig_filter (fig_filter_col.tex) with the same
    blocks, gates and crossing-free routing: PE 0 in full, PE 1-3 collapsed,
    the NOR beside the arbiter box. Placed in Section V-A with a caption that
    names every element in the text's terms.
    Paid for in space by folding the rejected mechanisms into a single Directed
    Invalidation section, shortening the timing, coherence-verification,
    limitations and conclusion paragraphs, dropping the control-region row
    from Table II, and trimming Fig. 3's height. Body still ends on page 6.
2026-09-18 Say cache busy time, not execution time, for the 6-33% share
    The counter is snoop-stall cycles over DCU busy cycles, so the share is of
    the time a core has an access in its cache, not of its total execution
    time. The abstract said "execution time" and the conclusion said "cache
    time"; both now say "cache busy time", the introduction says "the time a
    core spends with an access in its cache", and Section IV-A defines the term
    once and states explicitly what it excludes.
2026-09-18 State the difference from conventional snoop filtering in the abstract
    The abstract described the filter but never said what makes it different
    from existing ones. It now says that conventional filters sit at the
    receiving cache and use approximate or coarse-grained sharing information,
    whereas ours is exact, sits at the source and takes part in the arbitration
    decision, because on this bus the dominant cost of an unnecessary
    invalidation is the global serialization rather than the remote tag lookups.
    The introduction's claim about adopting a coherent fabric was too strong.
    "Means adopting its interconnect and, in most cases, modifying the core"
    becomes "generally means integrating with its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
2026-09-18 Strengthen Related Work and state the novelty as source-side exactness
    Related Work was too short to carry the novelty claim. It now says what
    JETTY, coarse-grain coherence tracking and RegionScout were designed for
    (SMP servers and large CMPs, where a useless snoop costs the energy and
    bandwidth of remote tag lookups) and why an approximate answer is good
    enough there: the error is one-sided, and a false claim of residency costs
    only a lookup that would have happened anyway.
    It then gives the three consequences of this bus charging in serialization
    instead, which together are what distinguishes this work: the filter must
    sit at the source and take part in arbitration, because a receiving-s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
2026-09-18 Answer the workload question with the sharing kernel, and simplify Fig. 1
    The four benchmark kernels are data-parallel, so "none of the invalidations
    are useful" invites the obvious objection that the workloads were chosen to
    make it true. Section IV-B now raises that objection itself rather than
    leaving it implicit, and explains why the result is not an artefact of the
    selection: what the filter removes is not sharing but the announcement of
    writes to caches that do not hold the line, and a workload can share a great
    deal while still making almost all of those announcements pointless.
    New Section VI-C carries the evidence. The halo-exchange stencil, 32x32 over
    eight steps with every PE exc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
2026-09-18 Check the filter's safety properties as assertions, not as a counter
    The paper asserted that the mirror "cannot drift" from the cache state and
    supported the fill-in-flight term with a counter that fired on 20 of 2,241
    grants. A counter shows a case was reached; it says nothing about the cycles
    where it was not. tb/sva/filter_sva.sv states the claims as properties and
    checks them every cycle:
    P1 every mirror entry equals the corresponding entry of that DCU's
    Status-RAM and Tag-RAM, in the valid bit and, where valid, the tag
    P2 a granted INV REQ that is not broadcast addresses a line no other DCU
    holds
    P3 the same for a DCU that holds nothing yet but is fetching the line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
    [sva_sweep.csv]
2026-09-18 Prove the filter's safety property, unbounded, by model checking
    The reviewer asked for formal verification of the exactness claim. It is
    proved, not asserted: fv/filter_fv.sv compares the filter against a reference
    model of a single cache entry, with the entry -- core, set, way -- left free
    for the solver, so a proof covers every entry of every cache. Nothing
    constrains the update port, so it holds for every sequence of fills and
    invalidations the caches could produce.
    p_exact if the reference entry is valid and its tag matches the queried
    address, and it is not the querying core's own, held_o must be set
    for that core. A false negative here makes the bus suppress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
    [fv_geometry.csv]
